PTR-projects/PTR_arecorder/docs/Arecorder_v.2.2_2016.07.30.pdf

# Arecorder

v. 2.2


## Arkadiusz Palinski ´

## Gdansk, 2016 rok ´

## Podziękowania

Specjalne podziękowania dla Andrzeja i Roberta Magiery, bez których nie udałoby mi się stworzyc Arecordera. ´

## Spis tresci ´

3.1.2. | Własciwe dane pomiarowe | ´ | 13
4.5. Stan 3 - silnik pierwszego stopnia się wyczerpał, oczekiwanie na minięcie
4.6. Stan 4 - oczekiwanie na odpalenie silnika drugiego stopnia i jednoczesne
4.9. Stan 7 - wyzwolono spadochron-pilot, oczekiwanie na wyst ąpienie

Spis tresci ´

4.14. Sygnalizowanie błędów i ostrzeze˙ n | ´ | 25

## 1. Wstęp

— pomiar cisnienia w zakresie 0 - 110 kPa (w zakresie 50 - 110 kPa z dokładno- ´

sci ą 100 Pa), ´
— pomiar przyspieszenia - trzy osie ± 24 g, jedna os (wzdłu ´ | z osi rakiety) ˙ | ± 80 g,
— pomiar temperatury wewn ątrz rakiety w zakresie -50 do +130 [◦C],

— zapis danych na karcie micro SD,

— próbkowanie danych z częstotliwosci ą 100 ´

Sa
s

,

— zaimplementowany filtr Kalmana do odszumienia pomiarów cisnienia, ´

— wykrywanie i sygnalizowanie podpiętych zapalników,

— wyzwalanie trzech zapalników - dwóch spadochronów i drugiego stopnia ra-

kiety,

— wyzwalanie spadochronu głównego po wykryciu awarii spadochronu-pilota,

— wykrywanie i zapis k ąta pochylenia rakiety na wyrzutni,

— pomiar napięcia zasilania Arecordera,

— programowalny czas opóźnienia pomiędzy koncem pracy pierwszego silnika a ´

odpaleniem silnika drugiego stopnia,

— wybór jednego z czterech zestawów parametrów konfiguracyjnych Arecordera,

— programowanie parametrów konfiguracyjnych Arecordera oraz imienia, nazwi-

ska i numeru telefonu własciciela oraz programowania prędko ´ | sci opadania ra- ´

kiety koniecznej do zadziałania awaryjnego wyzwalania spadochronu głów-

nego lub jego wył ączania za pomoc ą programu na komputerze PC,
— zapis podsumowania lotu w formie kilkunastu najwazniejszych parametrów ˙

lotu.

Arecorder jest urz ądzeniem przeznaczonym do rejestrowania danych podczas

lotu rakiety oraz wyzwalania zapalników w okreslonych chwilach. Urz ądzenie jest ´
przeznaczone do rakiet modelarskich srednich i du ´ | zych, równie ˙ | z dwustopniowych ˙

i naddźwiękowych. Zastosowane algorytmy pozwalaj ą na wykrycie sytuacji niety-
powych (np. lot pod duzym k ątem) i odpowiednio na nie zareagowa ˙ | c zmniejszaj ąc ´

ryzyko zniszczenia rakiety.
Nie jest konieczne przeczytanie całej instrukcji. Uzytkownik powinien jednak ˙

przeczytac rozdziały 1, 2, 4.2 i 4.3 oraz 7. ´

ROZDZIAŁ 1. WST ĘP

UWAGA - Jesli działanie Arecordera w dowolnym momencie odbiega od ´
zamierzonego, nalezy przesła ˙ | c wszelkie informacje o locie (w szczegól- ´

nosci pomiary Arecordera oraz filmy z lotu rakiety) na adres konstruktora ´

arekpalinski@gmail.com w celu weryfikacji działania Arecordera i ewen-

tualnej korekcji błędów. Konstruktor zastrzega sobie prawo do uaktualnie-

nia instrukcji bez uprzedniego powiadomienia

## 2. Opis wyprowadzen´

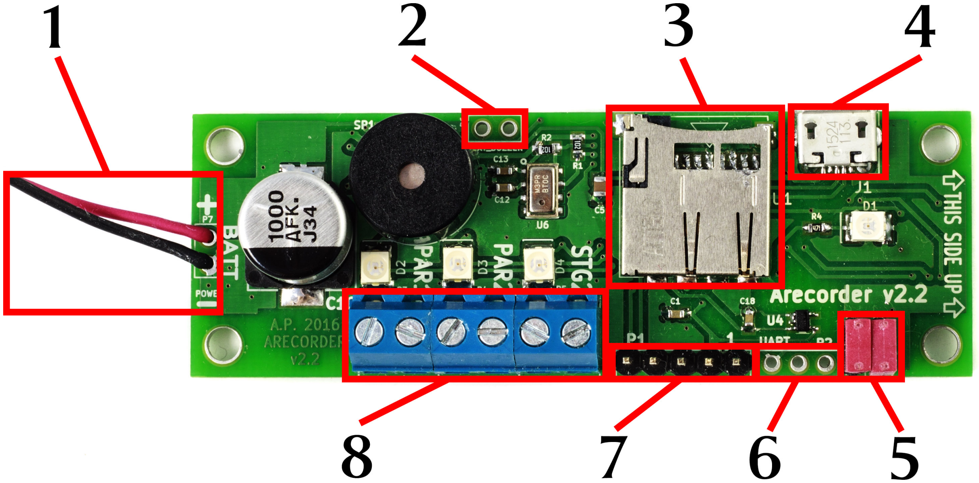
[picture p19: figure]

Rysunek 2.1: Opis wyprowadzen Arecordera. ´

1. zł ącze zasilania 2.1,
2. zł ącze dodatkowego brzęczyka 2.2,
3. zł ącze karty micro SD 2.3,
4. zł ącze USB programuj ące parametry Arecordera 2.4,
5. zł ącze wyboru zestawu ustawien 2.5, ´
6. zł ącze dodatkowe (obecnie nieaktywne),
7. zł ącze programuj ące mikrokontroler 2.6,
8. zł ącze do podł ączenia zapalników 2.7.

### 2.1. Zasilanie

Jako zasilanie moze by ˙ | c wykorzystane dowolne źródło napięcia w zakresie ´
4 - 10 V o niskiej impedancji (tj. mog ące oddac du ´ | zy pr ąd). Je ˙ | sli Arecorder jest ´

wykorzystywany wył ącznie jako rejestrator danych (nie ma wyzwalac zapalników ´
i nie s ą one do niego podł ączone), to zasilac go mo ´ | zna dowolnym źródłem napięcia ˙

w zakresie 3,8 - 10 V.

Zalecane zasilanie to jedno lub dwa ogniwa LiPo (w przypadku pojedynczego

ogniwa powinno ono byc w pełni naładowane). ´
Zobacz tez podrozdziały 5.1 i 5.2. ˙

ROZDZIAŁ 2. OPIS WYPROWADZEN´

### 2.2. Zł ącze dodatkowego brzęczyka

Do zł ącza dodatkowego brzęczyka mozna doł ączy ˙ | c dowolny brzęczyk, który ´
moze by ˙ | c zasilany stałym napięciem. Maksymalne napięcie zasilania doł ącza- ´
nego brzęczyka musi byc większe ni ´ | z napięcie zasilania Arecordera. Dodatkowy ˙
brzęczyk powinien byc stosowany jedynie w sytuacji, gdy gło ´ | sno ´ sć wbudowanego ´

brzęczyka jest niewystarczaj ąca.

### 2.3. Zł ącze karty micro SD

Tabela 2.1: Wkładanie i wyjmowanie karty SD

Nalezy wło ˙ zy˙ c kartę w otwór, lekko ´ docisn ąc i pu ´ sci ´ c. Karta cofnie się ´ odrobinę i zostanie zablokowana.

Aby wyj ąc kartę nale ´ zy j ą ponownie ˙ docisn ąc i pu ´ sci ´ c, karta cofnie się i bę- ´ dzie mozna j ą łatwo wyj ą ˙ c.´

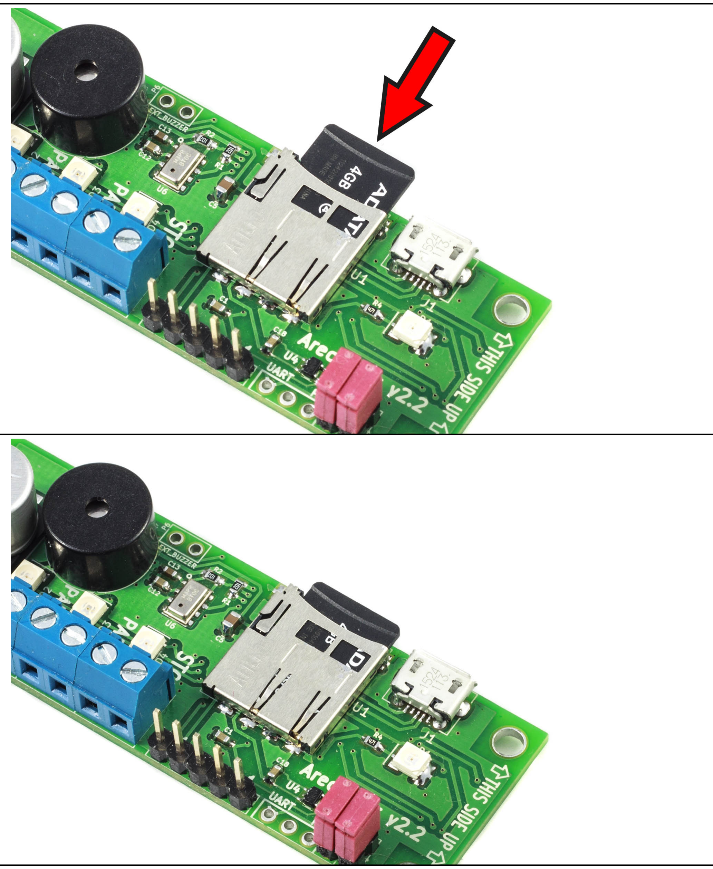
[picture p20: figure]

Do zł ącza karty SD nalezy wło ˙ zy˙ c kartę micro SD. Na tę kartę będ ą zapisywane ´

wszystkie pomierzone dane. Arecorder jest w stanie zapisac pliki o numerach ´ od 1 do 99 na jednej karcie (kazde wł ączenie Arecordera powoduje utworzenie ˙

dwóch plików o takich samych numerach - jednego pliku z danymi i jednego pliku
z podsumowaniem lotu), zaleca się jednakze formatowanie karty przed ka ˙ | zdym ˙

lotem.

Bardzo zalecana jest karta micro SDHC o mniejszej pojemnosci (mniejszej ´ niz 32 GB). ˙
Zaleca się formatowanie karty SD przed kazdym lotem, jednak ˙ | ze nie jest ˙

to konieczne.

ROZDZIAŁ 2. OPIS WYPROWADZEN´

### 2.4. Zł ącze USB programuj ące parametry Arecordera

Do zł ącza programuj ącego parametry Arecordera mozna podł ączy ˙ | c komputer ´

PC, na którym został zainstalowany program AreConfig. Umozliwi to zmiany na- ˙

staw konfiguracyjnych Arecordera, wpisanie imienia, nazwiska oraz numeru te-
lefonu własciciela, mo ´ | zliwo ˙ | sci wył ączenia awaryjnego wyzwalania spadochronu ´

głównego oraz przetestowanie wyzwalania zapalników.
Aby poł ączyc Arecorder z programem AreConfig nale ´ | zy wykona ˙ | c następuj ące ´
czynnosci w podanej kolejno ´ | sci: ´
1. Podł ączyc Arecorder poprzez kabel USB do komputera, ´
2. Wł ączyc program AreConfig, ´
3. Wybrac port, do którego doł ączony jest Arecorder. Zwykle wła ´ | sciwy port po- ´
winien byc wybrany od razu po wł ączeniu programu, je ´ | sli jednak tak nie jest ´
lub program wł ączono przed podł ączeniem Arecordera nalezy klikn ą ˙ | c przycisk ´
Przeskanuj i spróbowac poł ączy ´ | c się z wła ´ | sciwym portem. Zwykle powinien ´
byc jeden wykryty port. Je ´ | sli na li ´ | scie jest więcej ni ´ | z jeden port, mo ˙ | zna klik- ˙
n ąc prawym przyciskiem myszki na ´ | Mój Komputer i z rozwijanej listy wybrac´
Własciwo ´ | sci ´ , dalej Zaawansowane ustawienia systemu i w zakładkce Sprzęt
klikn ąc przycisk ´ | Menedzer urz ądze ń ˙ | . Z listy rozwin ąc pozycję ´ | Porty (COM i

LPT) - port, do którego jest podł ączony Arecorder będzie miał nazwę rozpo-

czynaj ąc ą się od USB Serial Port,

4. . Klikn ąc przycisk ´ | Poł ącz,
5. Arecorder automatycznie zostanie wykryty i poł ączy się z programem

AreConfig.

### 2.5. Zł ącze wyboru programu

Zł ącze wyboru zestawu ustawien słu ´ | zy do wyboru jednego z czterech pro- ˙
gramów - zestawów zaprogramowanych wczesniej ustawie ´ | n, za pomoc ą zworek. ´
Ustawienia, które s ą zmieniane w zalezno ˙ sci od wyboru programu to: ´
— wysokosć, na jakiej ma zosta ´ | c wyzwolony spadochron główny, ´

— wysokosć wyrzutni, ´

— opóźnienie wł ączenia silnika drugiego stopnia po zakonczeniu pracy silnika ´

pierwszego stopnia,

— prędkosci opadania rakiety, przy której nast ąpi awaryjne wyzwolenie spado- ´

chronu głównego (prędkosć “0” oznacza wył ączenie awaryjne wyzwolenie ´

spadochronu głównego).

Arecorder próbkuje zł ącze tylko raz, podczas wł ączenia. Późniejsze wyjęcie
lub włozenie zworek nie spowoduje zmiany ustawie ˙ | n.´

ROZDZIAŁ 2. OPIS WYPROWADZEN´

Tabela 2.2: Wybór numeru programu za pomoc ą zworek

numer programu

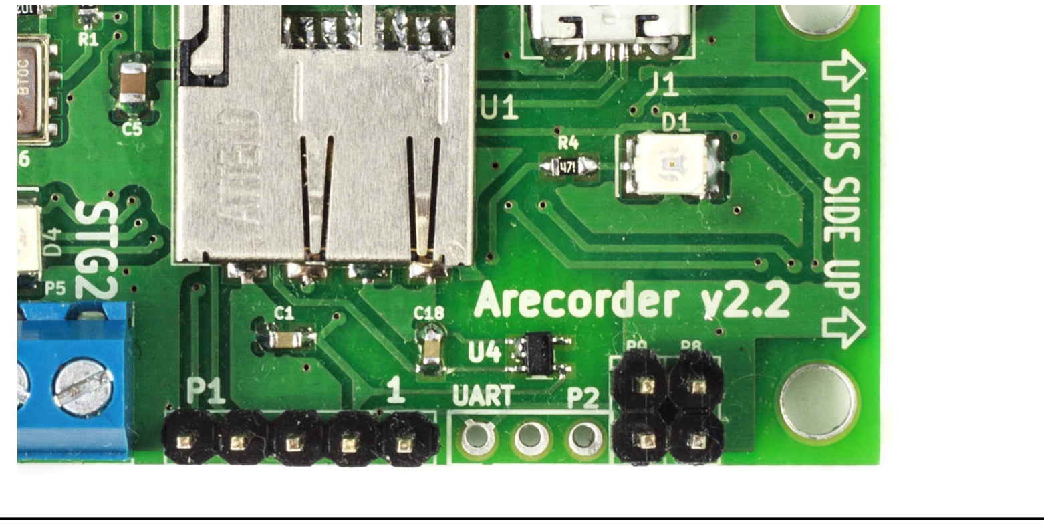
[picture p21: figure]

1

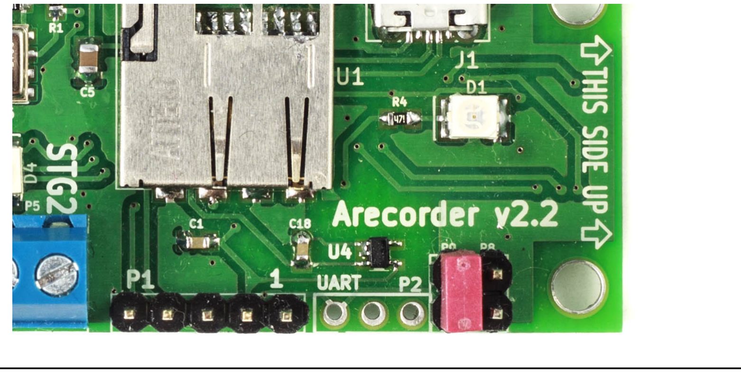
[picture p22: figure]

2

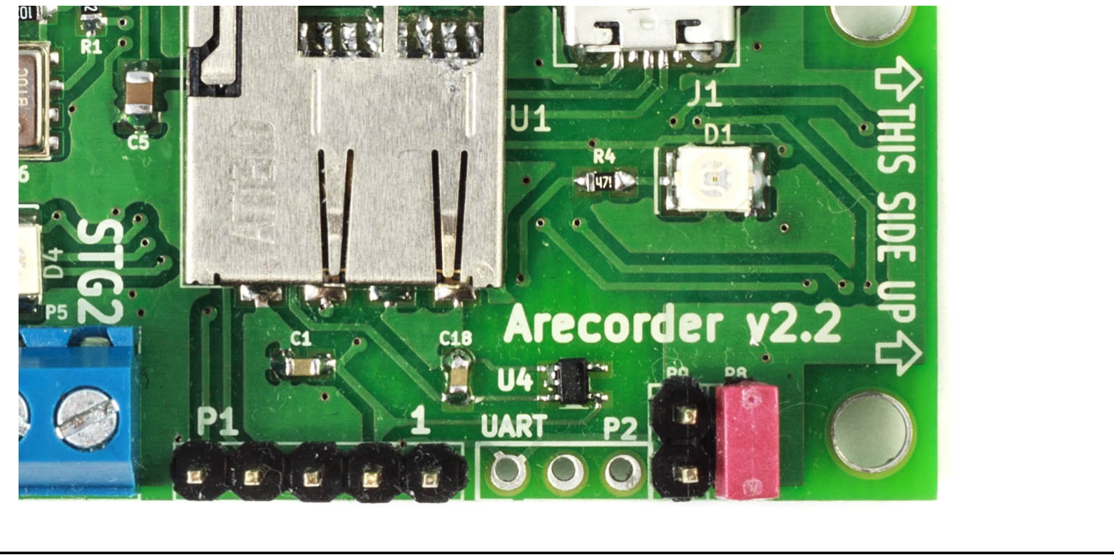
[picture p23: figure]

3

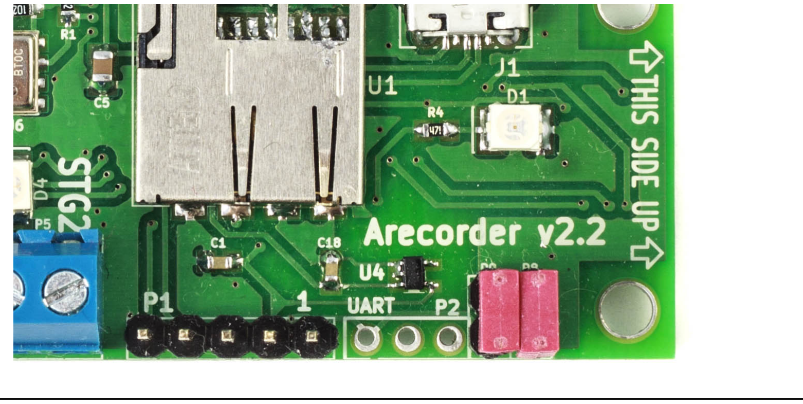
[picture p24: figure]

4

Tabela 2.3: Domyslne warto ´ | sci programów ´

numer

programu

spadochron

główny [m]

wysokosć´

wyrzutni [m]

opóźnienie

wyzwolenia zapalnika

drugiego stopnia [s]

awaryjne wyzwalanie

spadochronu przy

prędkosci [m/s] ´
1 | 200 | 1 | 0 | 50
2 | 150 | 1 | 0 | 50
3 | 100 | 1 | 0 | 50
4 | 50 | 1 | 0 | 50

ROZDZIAŁ 2. OPIS WYPROWADZEN´

### 2.6. Zł ącze programuj ące mikrokontroler

Zł ącze programuj ące mikrokontroler jest uzywane do aktualizacji oprogramo- ˙

wania Arecordera. Uzytkownik nie powinien u ˙ | zywa ˙ | c tego zł ącza. ´

### 2.7. Wyzwalanie zapalników

Zapalniki powinny byc doł ączone do odpowiedniego wyj ´ | scia (PAR1, PAR2 lub ´

STG2, które oznaczaj ą wyzwolenie zapalników odpowiednio spadochronu-pilota,

spadochronu głównego oraz drugiego członu rakiety).
Kazdy z zapalników jest doł ączony do zasilania dodatniego oraz do drenu od- ˙

powiadaj ącego mu tranzystora. W przypadku wyzwolenia zapalnika, tranzystor

jest wł ączany, co powoduje doł ączenie do zapalnika masy zasilania i przepływ
pr ądu o duzym natę ˙ | zeniu (zale ˙ | znym od źródła zasilania). ˙
Do kazdego z zapalników doł ączony jest tak ˙ | ze dodatkowy tranzystor, którego ˙

wł ączenie powoduje przepływ niewielkiego pr ądu przez zapalnik oraz diodę LED. Pr ąd ten jest zalezny od napięcia zasilania i wynosi ok. 2 - 8 mA. Jest to zbyt mały ˙

pr ąd, aby spowodował wyzwolenie zapalnika, a wystarczaj ący aby dioda LED za-
swieciła się informuj ąc, ´ | ze do danego wyj ˙ | scia doł ączony jest zapalnik. ´

## 3. Format danych zapisywanych na karcie SD

Dane s ą zapisane w formacie CSV, tj. poszczególne kolumny danych s ą od-

dzielone przecinkami a wiersze s ą oddzielone znakami nowej linii. Dane w takim
formacie mozna otworzy ˙ | c w dowolnym arkuszu kalkulacyjnym (przy importowa- ´
niu danych nalezy wybra ˙ | c język angielski - spowoduje to prawidłowe rozpoznanie ´

kropek jako znaków separuj ących częsci ułamkowe. ´

### 3.1. Format danych pliku z danymi pomiarowymi

Plik z danymi pomiarowymi dzieli się na trzy częsci - nagłówek, wła ´ | sciwe dane ´

pomiarowe oraz dane podsumowuj ące.

### 3.1.1. Nagłówek

W nagłówku zapisane s ą dane konfiguracyjne oraz kalibracyjne Arecordera
oraz imię, nazwisko i numer telefonu własciciela a tak ´ | ze informacje o wersji za- ˙

równo układu jak i oprogramowania Arecordera.

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

ROZDZIAŁ 3. FORMAT DANYCH ZAPISYWANYCH NA KARCIE SD

22 Sam ple s p e r sec o n d , 1 0 0
23
24 s e c o n d s , X_acc , Y_acc , Z_acc , HX_acc . . .
1. linia informuj ąca o wersji płytki Arecordera,
2. linia informuj ąca o wersji oprogramowania Arecordera (jest to czas, kiedy zo-

stał skompilowany kod),

3. numer seryjny,
4. nazwisko własciciela tego egzemplarza Arecordera, ´
5. numer telefonu własciciela, ´
6. numer zestawu ustawien wybranych w chwili wł ączenia Arecordera, ´
7. liczba działek, o które zmieniaj ą się wskazania akcelerometru ±24 g przy

zmianie przyspieszenia o 1 g,
8. liczba działek, o które zmieniaj ą się wskazania akcelerometru ±80 g przy

zmianie przyspieszenia o 1 g,
9. dana kalibracyjna - wartosć, jak ą wskazuje o ´ | s X akcelerometru ´ | ±24 g, gdy

mierzone przyspieszenie wynosi 0 g,
10. dana kalibracyjna - wartosć, jak ą wskazuje o ´ | s X akcelerometru ´ | ±80 g, gdy

mierzone przyspieszenie wynosi 0 g,
11. dana kalibracyjna - wartosć, jak ą wskazuje o ´ | s Y akcelerometru ´ | ±24 g, gdy

mierzone przyspieszenie wynosi 0 g,
12. dana kalibracyjna - wartosć, jak ą wskazuje o ´ | s Z akcelerometru ´ | ±24 g, gdy

mierzone przyspieszenie wynosi 0 g,
13. informacja o wykryciu czujnika ±80 g,
14. opóźnienie odpalenia silnika drugiego stopnia rakiety po zakonczonej pracy ´

silnika pierwszego stopnia (w sekundach),

15. wysokosć, na której powinien zosta ´ | c wyzwolony spadochron główny (w me- ´

trach),

16. wysokosć wyrzutni, z której rakieta startuje (w metrach), ´
17. prędkosci opadania rakiety, powy ´ | zej której zostanie wyzwolony spadochron ˙

głównego w przypadku awarii spadochronu pilota, wartosć zerowa oznacza ´

wył ączenie algorytmu,

18. dana kalibracyjna - wartosć, która jest odejmowana od wskaza ´ | n czujnika tem- ´
peratury (dane zapisywane s ą juz po korekcie, w stopniach Celsjusza), ˙
19. wartosć pierwszego współczynnika u ´ | zywanego przy obliczaniu wysoko ˙ | sci z ´

cisnienia, ´
20. wartosć drugiego współczynnika u ´ | zywanego przy obliczaniu wysoko ˙ | sci ci- ´

snienia, ´

21. cisnienie na poziomie morza (w Pa), warto ´ | sć stała, ´
22. liczba zapisywanych pomiarów w ci ągu sekundy,

ROZDZIAŁ 3. FORMAT DANYCH ZAPISYWANYCH NA KARCIE SD

24. opis poszczególnych kolumn własciwych danych. ´

### 3.1.2. Własciwe dane pomiarowe ´

Dane własciwe składaj ą się z następuj ących po sobie linii z danymi. W ka ´ | zdej ˙
linii poszczególne wartosci s ą oddzielone od siebie przecinkami, warto ´ | sci ułam- ´

kowe zapisywane s ą po kropce. Linia danych konczy się znakiem nowej linii (czyli ´

“enterem”).

Przykładowa linia danych wygl ąda następuj ąco:

48.81,145,34,-28,-10,102186,102182,14.9,2.4,0,0.3,1,0.0,0

gdzie:

48.81 | — czas w sekundach oraz w setnych częsciach sekund, ´
145,34,-28,-10 | — surowe dane przyspieszenia w osi X, osi Y, osi Z akcelero-
metru ±24 g oraz w osi X akcelerometru ±80 g (patrz sekcja

3.1.4),

102186,102182 | — cisnienie pomierzone bezpo ´ | srednio przez czujnik ci ´ | snienia ´
oraz cisnienie po u ´ | srednieniu przez filtr Kalmana, dane w [Pa], ´
14.9 | — temperatura pomierzona przez czujnik temperatury znajdu-
j ący się na Arecorderze, dane w [◦C]
2.4 | — prędkosć w osi rakiety obliczona przez Arecorder, dane ´ w [m s ]
0 | — wysokosć wyliczana z ci ´ | snienia, dane w [m], ´
0.3 | — wysokosć wyliczana z przyspieszenia, dane w [m], ´
1 | — numer stanu, w którym aktualnie znajduje się Arecorder
| (patrz tabela 4.1),
0.0 | — prędkosć wyliczana z ci ´ | snienia, ´
0 | — zmienna pomocnicza obliczana tylko w stanie 7 (patrz rów-
| niez 4.9), ˙

### 3.1.3. Dane podsumowuj ące

Jest to kopia danych z pliku podsumowuj ącego, patrz opis danych podsumo-

wuj ących w sekcji 3.2.

### 3.1.4. Konwersja danych

Aby pomierzone surowe dane z akcelerometrów były uzyteczne, nale ˙ | zy doko- ˙

nac konwersji na wybran ą jednostkę. ´

ROZDZIAŁ 3. FORMAT DANYCH ZAPISYWANYCH NA KARCIE SD

Aktualne wartosci X_1_g, Hx_1_g, X_0_g, Y_0_g, Z_0_g oraz Hx_0_g s ą ´

zawsze zapisywane w nagłówku pliku z danymi pomiarowymi.

a [g] = ameas − aof fset

again

, | (3.1)

gdzie:
a [g] - obliczone przyspieszenie w [g],

ameas - surowe dane z akcelerometrów,

aof fset - offset odpowiedni dla wybranego akcelerometru i osi odpowiednio X_0_g, Y_0_g, Z_0_g dla akcelerometru ±24 g lub Hx_0_g dla akcelerometru

±80 g,

again - współczynnik wzmocnienia, odpowiednio X_1_g dla akcelerometru ±24 g

lub Hx_1_g dla akcelerometru ±80 g.

a [

m
s

2

] = g · a [g], | (3.2)

gdzie:

a [

m
s

2 ] - obliczone przyspieszenie w [ m
s

2 ],
a [g] - obliczone przyspieszenie w [g], g - przyspieszenie grawitacyjne (9,81 m
s

2 ).

### 3.2. Format danych pliku z danymi podsumowuj ącymi

Dane podsumowuj ące s ą to lista kilkudziesięciu najwazniejszych parametrów ˙

charakteryzuj ących lot rakiety. Dane s ą zapisywane po wykryciu l ądowania ra-

kiety.

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

ROZDZIAŁ 3. FORMAT DANYCH ZAPISYWANYCH NA KARCIE SD

16 | R oc ket l a u n c h , 9 4 . 1 8 , [ s ]
17 | B u r n o ut o f f i r s t s t a g e e n gi n e , 9 5 . 5 2 , [ s ]
18 | I g n i t t i n g s e c o n d s t a g e e n gi n e f u s e , 9 5 . 6 3 , [ s ]
19 | F i r i n g s e c o n d s t a g e e n gi n e , 9 5 . 6 3 , [ s ]
20 | B u r n o ut o f s e c o n d s t a g e e n gi n e , 9 5 . 6 3 , [ s ]
21 | Apogee d e t e c t i o n , 1 0 3 . 7 2 , [ s ]
22 | Minimum v e l o c i t y a r o u n d apogee , 1 0 3 . 9 9 , [m/ s ]
23 | F i r i n g d r o g u e p a r a c h ut e , 1 0 4 . 7 0 , [ s ]
24 | F i r i n g main p a r a c h ut e , 1 2 5 . 7 6 , [ s ]
25 | R oc ket l a n di n g , 1 6 1 . 0 0 , [ s ]
26 | F i r s t e n gi n e b u r ni n g time , 1 . 3 4 , [ s ]
27 | Second e n gi n e b u r ni n g time , 0 , [ s ]
28 | Time t o apogee , 9 . 5 4 , [ s ]
29 | T o t a l f l i g h t time , 6 6 . 8 2 , [ s ]
1. k ąt, pod jakim pochylona jest rakieta na wyrzutni w chwili startu w stosunku do płaszczyzny podłoza, dane w [ ˙

◦
],
2. prędkosć w chwili opuszczenia wyrzutni, dane w [ ´

m
s

],

3. pomierzone cisnienie na poziomie ziemi w chwili startu, w [Pa], dane po filtrze ´

Kalmana,
4. pomierzone cisnienie w najwy ´ | zszym punkcie lotu, w [Pa], dane po filtrze Kal- ˙

mana,

5. maksymalna wartosć prędko ´ | sci w osi rakiety wyliczanej przez Arecorder z ´
przyspieszenia, dane w [m
s

],

6. maksymalna wysokosć osi ągnięta przez rakietę, w [m], dane wyliczone na pod- ´

stawie przyspieszenia,

7. maksymalna wysokosć osi ągnięta przez rakietę, w [m], dane wyliczone na pod- ´

stawie cisnienia, ´

8. prędkosć w chwili wykrycia ko ´ | nca pracy silnika pierwszego stopnia, dane ´
w [m
s

],

9. wysokosć w chwili wykrycia ko ´ | nca pracy silnika pierwszego stopnia, dane ´

w [m],

10. cisnienie w chwili wykrycia ko ´ | nca pracy silnika pierwszego stopnia, dane ´

w [Pa],

11. k ąt pochylenia rakiety do pionu w chwili wykrycia konca pracy silnika pierw- ´ szego stopnia, dane w [◦
],
12. prędkosć w chwili wykrycia ko ´ | nca pracy silnika drugiego stopnia, dane w [ ´

m
s

],

13. wysokosć w chwili wykrycia ko ´ | nca pracy silnika drugiego stopnia, dane ´

w [m],

14. cisnienie w chwili wykrycia ko ´ | nca pracy silnika drugiego stopnia, dane w [Pa], ´
15. k ąt pochylenia rakiety do pionu w chwili wykrycia konca pracy silnika dru- ´ giego stopnia, dane w [◦
],

ROZDZIAŁ 3. FORMAT DANYCH ZAPISYWANYCH NA KARCIE SD

16. czas, w którym został wykryty start rakiety, dane w [s],
17. czas, w którym został wykryty koniec pracy silnika pierwszego stopnia, dane

w [s],

18. czas, w którym został odpalony zapalnik rozpoczynaj ący pracę silnika dru-

giego stopnia, dane w [s],

19. czas, w którym został wykryty pocz ątek pracy silnika drugiego stopnia - wy-

zwolenie zapalnika nie jest jednoznaczne z rozpoczęciem pracy silnika dru-

giego stopnia, więc te dwa czasy s ą rozdzielone, dane w [s],

20. czas, w którym został wykryty koniec pracy silnika drugiego stopnia, dane

w [s],

21. czas, w którym zostało wykryte osi ągnięcie pułapu maksymalnego, dane w [s],
22. czas, w którym została wykryta minimalna prędkosć rakiety po sko ´ | nczeniu ´

pracy silników a przed wyzwoleniem spadochronu, dane w [s],

23. czas, w którym został odpalony zapalnik spadochronu-pilota, dane w [s],
24. czas, w którym został odpalony zapalnik spadochronu głównego, dane w [s],
25. czas, w którym zostało wykryte wyl ądowanie rakiety na ziemi (wykrycie na-

stępuje kilka sekund po faktycznym wyl ądowaniu), dane w [s],
26. czas pracy silnika pierwszego stopnia (róznica czasów pocz ątku i ko ˙ | nca pracy ´

silnika), dane w [s],
27. czas pracy silnika drugiego stopnia (róznica czasów pocz ątku i ko ˙ | nca pracy ´

silnika), dane w [s],

28. czas od chwili startu do osi ągnięcia przez rakietę pułapu, dane w [s],
29. całkowity czas lotu rakiety (czas od chwili wykrycia startu do chwili wykrycia l ądowania, z powodu opóźnienia w wykrycia l ądowania, ten czas moze by ˙ c o ´

kilka sekund za długi), dane w [s],

Dla danych od pozycji 16 do 21 oraz od 23 do 25 czas jest podawany od

chwili wł ączenia Arecordera.

## 4. Opis działania

Po wł ączeniu Arecorder jest w jednym ze zdefiniowanych stanów. Kazdy stan ˙

oznacza inn ą częsć lotu rakiety i inne decyzje podejmowane przez Arecorder. ´

Tabela 4.1: Stany Arecordera

numer stanu | opis
0 | oczekiwanie na inicjalizację
1 | oczekiwanie na start rakiety
2 | silnik pierwszego stopnia aktywny
3 | silnik pierwszego stopnia się wyczerpał, oczekiwanie na mi- nięcie opóźnienia odpalenia silnika drugiego stopnia
4 | oczekiwanie na odpalenie silnika drugiego stopnia i jednocze- sne oczekiwanie na osi ągnięcie pułapu
5 | silnik drugiego stopnia aktywny
6 | silnik drugiego stopnia się wyczerpał, oczekiwanie na osi ą- gnięcie pułapu
7 | wyzwolono spadochron-pilot, oczekiwanie na wyst ąpienie warunku wyzwolenia spadochronu głównego
8 | oczekiwanie na l ądowanie
9 | rakieta wyl ądowała
10 | zatrzymanie zapisywania danych
11 | pikanie brzęczyka

### 4.1. Obliczenia dokonywane przez Arecorder

Surowe dane pomierzone przez Arecorder to pomiary przyspieszenia w trzech osiach (±24 g w trzech osiach oraz ±80 g w osi rakiety), pomiary cisnienia oraz ´

pomiary temperatury (pomiar temperatury jako jedyny nie jest uzywany przez Are- ˙

corder do jakichkolwiek obliczen). Te dane s ą zapisywane w postaci surowej (bez- ´
posrednio odczytanej z czujników przez Arecorder, bez ´ | zadnej obróbki), jedynie ˙

temperatura jest konwertowana z pomierzonego napięcia na czujniku do wartosci ´ temperatury w [◦C] oraz dodawana jest do niej wartosć korekcji. ´

| Przed startem, Arecorder wylicza z przyspieszenia k ąt, pod jakim rakieta jest

pochylona na wyrzutni. Jest to k ąt pomiędzy osi ą rakiety a powierzchni ą prostopa-

ROZDZIAŁ 4. OPIS DZIAŁANIA


Rysunek 4.1: Osie, w których poszczególne akcelerometry mierz ą przyspieszenia.

dł ą do lokalnego pionu. K ąt ten jest uzywany do wyliczania wysoko ˙ | sci osi ągniętej ´
przez rakietę oraz prędkosci rakiety w czasie lotu; wa ´ | zne jest więc dokładne umiej- ˙
scowienie Arecordera we wnętrzu rakiety, aby os Arecordera i o ´ | s rakiety były jak ´
najbardziej do siebie zblizone. Zobacz tak ˙ | ze rysunek A.1. ˙

K ąt pochylenia rakiety jest cały czas aktualizowany, jesli więc po wł ączeniu ´

Arecordera a przed startem k ąt pochylenia rakiety ulegnie zmianie, to k ąt pochyłu

rakiety zostanie zaktualizowany a zmiana uwzględniona. Po wykryciu startu ra-
kiety k ąt jest blokowany do czasu, az rakieta opu ˙ | sci wyrzutnię. Następuje wtedy ´

obliczanie k ąta na podstawie przyspieszen działaj ących na rakietę (czyli ci ągu sil- ´
nika oraz grawitacji) i wczesniejszego k ąta. Zobacz tak ´ | ze wzór B.12. ˙
Arecorder moze zosta ˙ | c wł ączony, gdy rakieta jest w pozycji poziomej, zo- ´

stanie to prawidłowo wykryte.

Na podstawie przyspieszenia w osi rakiety oraz k ąta pochyłu rakiety podczas

lotu, Arecorder wylicza prędkosć rakiety w osi rakiety, prędko ´ | sć wznoszenia się ´
rakiety, wysokosć, na jak ą rakieta zdołała się wznie ´ | | sć oraz aktualizuje k ąt pochyłu ´

rakiety względem powierzchni ziemi. Prędkosć rakiety jest wyliczana z akcelero- ´ metru ±24 g, ale w przypadku, gdy pomierzone przez ten akcelerometr przyspie-

szenie będzie większe niz 20 g, to Arecorder będzie wyliczał prędko ˙ | sć korzystaj ąc ´
z danych z akcelerometru ±80 g.
Cisnienie jest na pocz ątku filtrowane filtrem Kalmana, aby je odszumi ´ | c. Na- ´
stępnie z cisnienia wyliczana jest warto ´ | sć wysoko ´ | sci pozycji startowej nad po- ´

ziomem morza, względem której będzie obliczana wysokosć, na któr ą wzleciała ´

rakieta.

ROZDZIAŁ 4. OPIS DZIAŁANIA

### 4.2. Stan 0 - oczekiwanie na inicjalizację

Po wł ączeniu zasilania, Arecorder wykrywa numer wybranego zestawu usta-

wien i piszczy brzęczykiem jego numer. Następnie odczytywane s ą ustawienia ´

z pamięci nieulotnej. Jesli wyst ąpi bł ąd w odczycie, Arecorder zasygnalizuje to ´
brzęczeniem brzęczyka. Moze to by ˙ | c jedynie ostrze ´ | zenie, Arecorder będzie kon- ˙
tynuował pracę, ale moze to te ˙ | z by ˙ | c bł ąd uniemo ´ | zliwiaj ący dalsze funkcjonowanie ˙
Arecordera. W dalszej kolejnosci inicjalizowany jest czujnik ci ´ | snienia - je ´ | sli ini- ´
cjalizacja się nie powiedzie, Arecorder zgłosi bł ąd - zobacz tez sekcję po ˙ | swięcon ą ´
błędom i ostrzezeniom 4.14. Następnie mierzy napięcie zasilania na baterii - je ˙ | sli ´

napięcie to jest zerowe, oznacza to, ze Arecorder jest zasilany ze zł ącza USB i ˙

przechodzi w tryb “Konfiguracji”. W przeciwnym wypadku Arecorder przechodzi

w tryb “Lotu”. Po przejsciu w okre ´ | slony tryb, Arecorder pozostaje w nim do ko ´ | nca ´
zasilania, umozliwia to późniejsze podł ączenie zasilania baterii w trybie “Konfi- ˙

guracji” w celu przetestowania zapalników. Taki sposób działania uniemozliwia ˙

przejscie w tryb “Konfiguracji” podczas lotu w rakiecie. ´

Przed decyzj ą o wyborze trybu działania, Arecorder inicjalizuje czujniki, od-

czytuje zaprogramowane ustawienia, zapisuje wartosć ci ´ snienia odniesienia (z któ- ´

rej jest wyliczana wysokosć bezwzględna wyrzutni) oraz rozpoczyna testowanie ´

obecnosci zapalników (gdy testowanie obecno ´ | sci zapalników jest wł ączone, czer- ´
wone diody LED zaczynaj ą się swieci ´ | c przy zapalnikach, które zostały wykryte). ´

### 4.2.1. Tryb konfiguracji

Aby przejsć w tryb konfiguracji, Arecorder musi zosta ´ | c doł ączony do kompu- ´

tera poprzez kabel USB. Na komputerze musi byc wł ączony program Areconfig ´

i wybrany odpowiedni port, poprzez który będzie następowała konfiguracja. Zo-

bacz instrukcję do programu Areconfig lub zajrzyj do sekcji 2.4 w celu uzyskania

dokładniejszego opisu.
W trybie konfiguracji mozna dokona ˙ | c edycji ustawie ´ | n Arecordera: ´
— wysokosć, na której ma zosta ´ | c wyzwolony spadochron główny, ´

— wysokosć wyrzutni, ´

— czas pomiędzy koncem pracy silnika pierwszego stopnia a odpaleniem silnika ´

drugiego stopnia,

— imię, nazwisko oraz numer telefonu własciciela. ´

Pomijaj ąc ostatni ą pozycję, wszystkie ustawienia programuje się osobno dla
czterech róznych zestawów ustawie ˙ | n wybieranych zworkami. ´
W | trybie | konfiguracji | Arecorder | pozostaje | cały | czas | w | stanie

AWAITING_FOR_ARECORDER_READY.

Szczegółowy opis konfiguracji jest zamieszczony w instrukcji obsługi pro-

gramu Areconfig - http://www.palinski.org/Areconfig.

ROZDZIAŁ 4. OPIS DZIAŁANIA

### 4.2.2. Tryb Lotu

W trybie lotu mierzone jest napięcie zasilania - jesli wynosi ono poni ´ | zej 3,8 V, ˙
Arecorder zgłasza ostrzezenie, zobacz tak ˙ | ze 4.14. Następnie inicjalizowana jest ˙

karta SD i następuje utworzenie dwóch plików, do których będ ą zapisywane dane

- pliku o nazwie “MEASxx.CSV” oraz “SUMMxx.CSV”, gdzie xx to numer nada-

wany kolejnym zapisywanym plikom z danymi na karcie SD; numery odpowiadaj ących sobie plików MEAS i SUMM s ą zawsze takie same. Przy kazdym wł ą- ˙

czeniu Arecorder odczytuje czy na karcie s ą zapisane jakies poprzednie pliki z ´

danymi i tworzy nowe pliki z numerem większym o jeden od poprzednio zapisa-
nego; Arecorder moze w ten sposób zapisa ˙ | c do 99 plików, zarówno MEAS jak i ´

SUMM, na jednej karcie SD. Zaleca się jednak kazdorazowe formatowanie karty ˙

przed kazdym lotem. Gdy liczba pomiarów na karcie przekroczy 90, Arecorder ˙

zgłosi ostrzezenie, natomiast gdy na karcie znajduje się ju ˙ | z 99 pomiarów, Arecoder ˙
zgłosi bł ąd, ze nie mo ˙ | ze ju ˙ | z zapisa ˙ | c więcej pomiarów, zobacz tak ´ | ze 4.14. ˙

Po utworzeniu plików na karcie, następuj ą trzy piski brzęczyka - kazdy z tych ˙

pisków oznacza obecnosć lub brak odpowiedniego zapalnika. Krótkim piskiem sy- ´

gnalizowana jest obecnosć zapalnika, natomiast długim jego brak. Pierwszy pisk ´

oznacza zapalnik spadochronu-pilota, drugi zapalnik spadochronu głównego, na-

tomiast trzeci zapalnik drugiego stopnia rakiety.

Następnie następuje zapis do pliku MEAS danych konfiguracyjnych oraz je-
den długi pisk informuj ący uzytkownika, ˙ | ze od tej chwili Arecorder dokonuje po- ˙

miarów i wykrywa start; od tej chwili równiez dioda zielona dioda LED zaczyna ˙

migac. Po dziesięciu sekundach wył ączane jest testowanie zapalników (czerwone ´

diody przestaj ą migac). Arecorder przechodzi do stanu 1. ´

UWAGA - Po wł ączeniu Arecordera i zasygnalizowaniu rozpoczęcia wy-

krywania startu, zalecane jest odczekanie około dwóch minut na ustabili-

zowanie wskazan czujnika ci ´ | snienia. ´
W przypadku wczesniejszego startu ró ´ | znica błędnych wskaza ˙ | n wysoko ´ | sci ´
obliczona z czujnika cisnienia mo ´ | ze wynie ˙ | sć nawet kilka metrów. ´
W celu skompensowania tego błędu nalezy do oblicze ˙ | n wysoko ´ | sci jako ci- ´
snienia odniesienia (wysoko ´ | sci wyrzutni) u ´ | zy˙ c warto ´ | sci ´ sredniej z dwóch ´
pomiarów cisnienia - jednego z danych lotu tu ´ | z przed startem rakiety oraz ˙

drugiego z miejsca startu rakiety czujnikiem po ustabilizowaniu wskazan,´

w niedługim czasie po wyl ądowaniu.

Arecorder za pomoc ą pisków brzęczyka informuje o wybranym zestawie usta-

wien, o doł ączonych zapalnikach oraz o rozpoczęciu wykrywania startu rakiety. ´

Najpierw liczba pisków informuje o wybranym zestawie parametrów. Po krótkiej

ROZDZIAŁ 4. OPIS DZIAŁANIA

przerwie następuj ą kolejne trzy piski informuj ące o wykrytych b ądź nie zapal-

nikach (krótki pisk oznacza wykryty zapalnik, długi brak wykrytego zapalnika).

Pierwszy pisk to zapalnik spadochrona-pilota, drugi - zapalnik głównego spado-

chronu a trzeci zapalnik silnika drugiego stopnia rakiety. Na koncu, po kolejnej ´ przerwie, występuje jeden długi pisk informuj ący, ze Arecorder rozpocz ął pomiary. ˙

Przykładowo, następuj ąca sekwencja pisków (krótka linia to krótki pisk, a
długa linia to długi pisk, dłuzsza przerwa oznacza zauwa ˙ | zalnie dłu ˙ | zsz ą przerwę ˙

między kolejnymi sekwencjami pisków):
- - | - - — | — oznacza, ze aktywny jest program drugi (wybrany jest drugi zestaw ustawie ˙ | n), ´

wykryto zapalniki podł ączone do obu spadochronów, ale nie do silnika drugiego
stopnia, oraz, ze Arecorder rozpocz ął pomiary i rakieta mo ˙ | ze startowa ˙ | c.´

### 4.3. Stan 1 - oczekiwanie na start rakiety

W tym stanie Arecorder jest zainicjalizowany i próbkuje dane z czujników w

celu wykrycia startu rakiety.

Start rakiety jest wykrywany, gdy rakieta wzniesie się na wysokosć większ ą ´
niz wysoko ˙ | sć wyrzutni (wysoko ´ | sć wyrzutni jest programowana wcze ´ | sniej). Na ´

podstawie pomiarów przyspieszenia jest wyliczana prędkosć rakiety oraz wyso- ´

kosć, na jak ą rakieta się wzniosła. Dodatkowo, je ´ | sli pomierzone przyspieszenie ´
jest większe niz 1,2 g (tzn. rakieta wznosi się do góry z przyspieszeniem więk- ˙

szym niz 0,2 g), to zostanie wł ączony brzęczyk informuj ący o potencjalnym starcie ˙

(az do potwierdzenia startu poprzez osi ągnięcie wysoko ˙ | sci wy ´ | zszej ni ˙ | z wysoko ˙ | sć´

wyrzutni).

Gdy po wł ączeniu Arecordera rakieta jest poruszana na wyrzutni, moze się ˙

zdarzyc,´ ze chwilowo zostanie wykryte przyspieszenie większe ni ˙ | | | z 1,2 g. ˙

Arecorder wł ączy na chwilę brzęczyk sygnalizuj ąc potencjalne wykrycie

startu, ale zaraz go wył ączy, gdy tylko chwilowe przyspieszenie znowu

spadnie. Jest to całkowicie normalne zachowanie a start nie zostanie wy-
kryty dopóki rakieta nie osi ągnie wysokosci wy ´ | zszej ni ˙ | z wysoko ˙ | sć wy- ´

rzutni.

W tym stanie, jesli nie jest wykrywany start, następuje aktualizacja ci ´ | snienia ´

odniesienia oraz k ąta pochylenia rakiety.

Jesli zostanie wykryty start rakiety, Arecorder zacznie zapisywa ´ | c dane na ´

kartę SD wraz z kilkunastoma próbkami danych przed startem. W chwili wykrycia

ROZDZIAŁ 4. OPIS DZIAŁANIA

startu zostanie równiez zapisany czas startu rakiety (do późniejszego pliku podsu- ˙

mowuj ącego).

Po wykryciu startu, Arecorder przechodzi do stanu 2.

### 4.4. Stan 2 - silnik pierwszego stopnia aktywny

W stanie drugim rakieta leci i silnik pierwszego stopnia jest aktywny, tj. siła

ci ągu silnika jest większa od oporu aerodynamicznego rakiety (czyli przyspiesze-

nie w osi rakiety jest większe od zera a rakieta zwiększa swoj ą prędkosć). Je ´ sli ´ przyspieszenie rakiety będzie mniejsze niz zero, zostanie wykryty koniec pracy ˙

silnika. Przyspieszenie jest filtrowane, przez co pojedynczy pomiar nie spowoduje

fałszywego zadziałania algorytmu.

Po wykryciu konca pracy silnika, zapisywany jest czas ko ´ | nca pracy silnika ´

pierwszego stopnia i Arecorder przechodzi do stanu 3.

### 4.5. Stan 3 - silnik pierwszego stopnia się wyczerpał, oczekiwanie na

minięcie opóźnienia odpalenia silnika drugiego stopnia

Stan trzeci to oczekiwanie, az minie zaprogramowany czas opóźnienia; po tym ˙

czasie zostaje wyzwolony zapalnik drugiego stopnia rakiety.
Równiez i tym razem jest zapisywany czas - czas wyzwolenia zapalnika dru- ˙

giego stopnia rakiety.

Po minięciu opóźnienia Arecorder przechodzi do stanu 4.

### 4.6. Stan 4 - oczekiwanie na odpalenie silnika drugiego stopnia i

jednoczesne oczekiwanie na osi ągnięcie pułapu

Stan czwarty to jednoczesnie oczekiwanie na odpalenie silnika drugiego stop- ´

nia i oczekiwanie na osi ągnięcie pułapu.
Jesli ci ąg silnika będzie większy ni ´ | z opór aerodynamiczny rakiety, to znaczy, ˙

ze silnik drugiego stopnia jest aktywny. W czasie gdy silnik drugiego stopnia jest ˙

aktywny, blokowane jest wyzwolenie spadochronu-pilota. Jesli silnik drugiego ´

stopnia będzie aktywny przez co najmniej pół sekundy, to Arecorder przechodzi

do stanu 5.

W przypadku braku silnika drugiego stopnia lub nieodpalenia silnika drugiego

stopnia, przez cały czas badany jest warunek wyzwolenia spadochronu-pilota. Ten warunek został opisany w stanie 6 - sekcja 4.8, gdyz s ą one identyczne. W przy- ˙

padku wyzwolenia spadochronu-pilota, Arecorder przechodzi do stanu 7.

W tym stanie jest zapisywany czas pocz ątku pracy silnika drugiego stopnia

lub, w przypadku braku silnika drugiego stopnia (lub nieodpalenia silnika dru-

ROZDZIAŁ 4. OPIS DZIAŁANIA

giego stopnia) zapisywany jest czas osi ągnięcia maksymalnego pułapu oraz czas

minimalnej prędkosci rakiety. ´

### 4.7. Stan 5 - silnik drugiego stopnia aktywny

W stanie pi ątym Arecorder wykrył wł ączenie silnika drugiego stopnia i oczekuje na koniec jego pracy. W tym stanie nie jest mozliwe wyzwolenie spadochronu. ˙

Podobnie jak w stanie drugim, jesli siła ci ągu silnika jest większa od oporu ´

aerodynamicznego rakiety, to Arecorder pozostaje w stanie 5, w przeciwnym przy-

padku Arecorder przechodzi do stanu 6.

W tym stanie zapisywany jest czas konca pracy silnika drugiego stopnia. ´

### 4.8. Stan 6 - oczekiwanie na osi ągnięcie pułapu

Stan szósty to wykrywanie osi ągnięcia pułapu rakiety. Arecorder bada czy
cisnienie zaczyna się zwiększa ´ | c (co oznacza obni ´ | zanie wysoko ˙ | sci, na której znaj- ´
duje się rakieta). Jesli ci ´ | snienie po filtrze Kalmana przez jedn ą sekundę będzie ´
większe niz najmniejsze zarejestrowane ci ˙ | snienie, to Arecorder podejmuje decyzję ´
co do dalszego postępowania na podstawie wysokosci wyliczonej z ci ´ | snienia. Je ´ | sli ´
wysokosć jest mniejsza ni ´ | z 200 metrów, to spadochron-pilot jest wyzwalany na- ˙
tychmiast. Jesli wysoko ´ | sć rakiety jest większa ni ´ | z 200 metrów, to Arecorder czeka ˙
z wyzwoleniem spadochronu-pilota, az wyliczona prędko ˙ | sć w osi rakiety spadnie ´

do minimum.

W przypadku, gdy k ąt pochylenia rakiety jest niewielki, prędkosć osiowa ra- ´
kiety po przekroczeniu pułapu moze osi ągn ą ˙ | c warto ´ | sć na tyle du ´ | z ą, ˙ ze wyzwolenie ˙

spadochronu-pilota spowodowałoby jego zerwanie. Po osi ągnięciu pułapu, tarcie
powietrza moze by ˙ | c na tyle du ´ | ze, ˙ | ze prędko ˙ | sć w osi rakiety zmniejsza się mimo ´
opadania rakiety (tuz po przekroczeniu pułapu o ˙ | s rakiety jest niemal równoległa ´

do płaszczyzny ziemi, przez co składowa grawitacji w osi rakiety jest mniejsza niz opór aerodynamiczny). Opóźnienie wyzwolenia spadochronu-pilota do czasu, ˙

az prędko ˙ | sć w osi rakiety osi ągnie warto ´ | sć minimaln ą ma na celu zmniejszenie ´

ryzyka zerwania spadochronu-pilota.

W tym stanie zapisywany jest czas osi ągnięcia pułapu, czas osi ągnięcia mi-
nimalnej prędkosci oraz minimalne pomierzone ci ´ | snienie, które jest u ´ | zywane do ˙

obliczenia maksymalnej wysokosci. ´

Po wyzwoleniu spadochronu-pilota, Arecorder przechodzi do stanu 7.

ROZDZIAŁ 4. OPIS DZIAŁANIA

### 4.9. Stan 7 - wyzwolono spadochron-pilot, oczekiwanie na wyst ąpienie

warunku wyzwolenia spadochronu głównego

W stanie siódmym Arecorder bada zachowanie się rakiety po wyzwoleniu

spadochronu-pilota. Jesli rakieta opada na spadochronie, to spadochron główny ´
jest wyzwalany, gdy rakieta opadnie ponizej zaprogramowanej wcze ˙ | sniej wysoko- ´
sci wyzwolenia spadochronu głównego (domy ´ | slnie 200 metrów). ´

Arecorder wyzwoli spadochron główny na zaprogramowanej wczesniej wyso- ´

kosci w odniesieniu do punktu startowego. Je ´ | sli rakieta będzie opada ´ | c w miejscu, ´
które jest połozone wy ˙ | zej nad poziomem morza ni ˙ | z miejsce startu, faktyczna wy- ˙
sokosć względna, na której zostanie wyzwolony spadochron mo ´ | ze by ˙ | c ni ´ | zsza ni ˙ | z˙
zaprogramowana. Analogicznie, jesli rakieta opada nad miejscem poło ´ | zonym ni ˙ | zej ˙
nad poziomem morza niz miejsce startu, faktyczna wysoko ˙ | sć względna, na której ´
zostanie wyzwolony spadochron główny moze by ˙ | c wy ´ | zsza ni ˙ | z zaprogramowana. ˙
UWAGA - uzytkownik powinien wzi ą ˙ | c pod uwagę ukształtowanie terenu ´

w okolicy miejsca startowego podczas programowania wysokosci, na któ- ´

rej ma zostac wyzwolony spadochron główny. ´

Po wyzwoleniu spadochronu-pilota działa równoczesnie algorytm, który ma ´

za zadanie wykrycie czy spadochron-pilot został wyzwolony prawidłowo. Jesli ´
Arecorder wykryje, ze rakieta opada zbyt szybko, powy ˙ | zej okre ˙ | slonej prędko ´ | sci, ´

zostaje natychmiast wyzwolony spadochron główny. Graniczna prędkosć opada- ´
nia rakiety jest programowalna przez uzytkownika (wpisanie warto ˙ | sci 0 powoduje ´

wstrzymanie działania algorytmu, spadochron główny zostanie wtedy wyzwolony

tylko na zaprogramowanej wysokosci). ´

UWAGA - Jako wartosć progow ą prędko ´ | sci opadania rakiety zaleca się ´
ustawic warto ´ | sć dwa-trzy razy większ ą ni ´ | z prognozowan ą prędko ˙ | sć opada- ´
nia rakiety na spadochronie-pilocie. Domyslnie zaprogramowana warto ´ | sć´

to 50 [m/s].

W tym stanie Arecorder zapisuje czas wyzwolenia spadochronu głównego.

Po wyzwoleniu spadochronu głównego, Arecorder przechodzi do stanu 8.

ROZDZIAŁ 4. OPIS DZIAŁANIA

### 4.10. Stan 8 - oczekiwanie na l ądowanie

W tym stanie następuje badanie zmian cisnienia w celu okre ´ | slenia czy rakieta ´
wyl ądowała na ziemi. Poniewaz algorytm bada dane z filtru Kalmana, l ądowanie ˙
moze zosta ˙ | c wykryte nawet kilka sekund po faktycznym wyl ądowaniu rakiety. ´

W tym stanie Arecorder zapisuje czas wykrytego l ądowania rakiety.

Po wykryciu l ądowania, Arecorder przechodzi do stanu 9.

### 4.11. Stan 9 - rakieta wyl ądowała

Po wykryciu wyl ądowania rakiety, dla bezpieczenstwa Arecorder zapisuje jesz- ´

cze dziesięc sekund danych, po czym przechodzi do stanu 10. W stanie dziewi ątym ´ następuje równiez wł ączenie pikania brzęczyka. ˙

### 4.12. Stan 10 - zatrzymanie zapisywania danych

W stanie dziesi ątym następuje zatrzymanie zapisywania danych na kartę SD

oraz zapisanie danych podsumowuj ących zarówno do pliku z danymi podsumo-

wuj ącymi jak i do pliku z danymi pomiarowymi. Gdy wszystkie dane zostan ą

zapisane, Arecorder przechodzi do stanu 11.

### 4.13. Stan 11 - pikanie brzęczyka

W tym stanie co sekundę pika brzęczyk. Arecorder pozostaje w tym stanie

dopóki nie zostanie wył ączony.

### 4.14. Sygnalizowanie błędów i ostrzeze˙ n´

Istnieje kilka sytuacji, w których Arecorder nie moze kontynuowa ˙ | c działania ´
(błędy) albo ostrzega, ze Arecorder zbli ˙ | za się do stanu, gdy ju ˙ | z nie będzie mógł ˙
kontynuowac działania (ostrze ´ | zenia). Sygnalizowane jest to w następuj ący sposób: ˙

– przez sekundę piszczy brzęczyk oraz zapalona jest dioda, następnie przez pół

sekundy jest cisza a dioda jest zgaszona,

– zarówno brzęczyk piszczy a dioda jest zapalana tyle razy ile wynosi numer

błędu,

– przez sekundę piszczy brzęczyk oraz zapalona jest dioda,
– w przypadku ostrzezenia Arecorder kontynuuje działanie, ˙

– w przypadku błędu zapalana jest dioda a Arecorder wstrzymuje dalsze działa-

nie.

ROZDZIAŁ 4. OPIS DZIAŁANIA

Kody błędów s ą następuj ące:

Tabela 4.2: Kody błędów

kod błędu | typ błędu | opis
1 | ostrzezenie ˙ | niski poziom baterii - napięcie zasilania jest ponizej ˙

3.8 V
2 | ostrzezenie ˙ | na karcie SD znajduje się ponad 90 pomiarów
3 | bł ąd | na karcie SD znajduje się 99 pomiarów, nie mozna ˙

zapisac więcej ´
4 | ostrzezenie ˙ | wewnętrzna pamięc nieulotna została zapisana zbyt ´

wiele razy (więcej niz kilkadziesi ąt tysięcy razy). ˙

Ostrzezenie zgłaszane jest znacznie wcze ˙ | sniej ni ´ | z˙

mog ą wyst ąpic błędy w odczycie i zapisie do pa- ´
mięci nieulotnej, ale nalezy rozwa ˙ | zy˙ c zaprzestanie ´

uzywania tego egzemplarza Arecordera ˙

5 | bł ąd | bł ąd zapisu danych na wewnętrzn ą, nieulotn ą pa-
mięc. Je ´ | sli problem będzie się powtarzał, nale ´ | zy˙
rozwazy˙ c zaprzestanie u ´ | zywania tego egzemplarza ˙

Arecordera

6 | bł ąd | nie udało się zainicjalizowac działania czujnika ci- ´

snienia ´
7 | ostrzezenie ˙ | bł ąd podczas wysyłania do Arecordera polecenia za-

pisu danych do pamięci nieulotnej. Prawdopodobnie
uzytkownik u ˙ | zywa niewła ˙ | sciwej wersji programu ´

AreConfig

## 5. Parametry techniczne

### 5.1. Absolutnie maksymalne parametry

UWAGA Obci ązenia większe ni ˙ | | z opisane jako ˙ | Absolutnie maksymalne pa-

rametry mog ą spowodowac trwałe uszkodzenie Arecordera. To s ą tylko ´ maksymalne obci ązenia - prawidłowa praca Arecordera pod tymi obci ą- ˙

zeniami lub większymi ni ˙ | z opisanymi jako ˙ | Parametry elektryczne nie jest

gwarantowana. Długotrwałe wystawienie Arecordera na działanie maksy-
malnych obci ąze˙ n mo ´ | ze wpłyn ą ˙ | c na niezawodno ´ | sć urz ądzenia. ´

Tabela 5.1: Absolutnie maksymalne parametry

Parametr | Min | Maks | Jednostka | Uwagi
Napięcie zasilania | -0,7 | 10,5 | V
Przyspieszenie | - | 1000 | g | 1) , 2)
Cisnienie ´ | 0 | 110 | kPa
Temperatura podczas pracy | -50 | 85 | [ ◦C]
Temperatura podczas przechowywania | -50 | 125 | [ ◦C]
1) nie przetestowane w praktyce,
2) w dowolnej osi.

ROZDZIAŁ 5. PARAMETRY TECHNICZNE

### 5.2. Parametry elektryczne

Tabela 5.2: Parametry elektryczne

Parametr | Min | Typ | Maks | Jednostka | Uwagi
Napięcie zasilania | 4 | 4,2 | 10,5 | V | 1)
| 3,8 | 4,2 | 10,5 | V | 2)
Pobór pr ądu | 28,8 | - | 31,7 | mA | 3) 4)
| 30 | - | 36 | mA | 3) 5)
| - | 35 | - | mA | 6)
Zakres mierzonego przyspieszenia | 0 | - | 24 | g | 7)
| 0 | - | 80 | g | 8)
Rozdzielczosć´ mierzonego przyspieszenia | - | 0,042 | - | g | 7)
| - | 0,012 | - | g | 8)
Zakres mierzonego cisnienia ´ | 0 | - | 110 | kPa
Rozdzielczosć mierzonego ´ cisnienia ´ | - | 1,5 | - | Pa

Zakres mierzonej

temperatury

-55 | - | 130 | [
◦C] | 9)

Rozdzielczosć mierzonej ´

temperatury

- | 0,25 | - | [ ◦C]
1) w przypadku, gdy Arecorder wyzwala zapalniki,
2) w przypadku, gdy Arecorder jedynie mierzy parametry lotu,
3) pomijaj ąc chwilę, gdy zapalnik jest wyzwalany,
4) pobór pr ądu gdy dane nie s ą zapisywane na kartę SD,
5) pobór pr ądu gdy dane s ą zapisywane na kartę SD,
6) sredni pobór pr ądu w stanie 11 - pikanie brzęczyka, ´
7) akcelerometr LIS331HH, wszystkie trzy osie,
8) akcelerometr MMA6519, jedna os,´
9) zakres pomiarowy czujnika temperatury przekracza zakres pracy całego

Arecordera,

ROZDZIAŁ 5. PARAMETRY TECHNICZNE

### 5.3. Parametry fizyczne i mechaniczne

Tabela 5.3: Parametry fizyczne i mechaniczne

Parametr | | Jednostka | Uwagi
Szerokosć´ | 25 | mm | 1)
Długosć´ | 74 | mm
Wysokosć´ | 14 | mm | 2)
Masa | 16,4 | g
1) w przypadku podł ączenia zapalników, nalezy zostawi ˙ | c dodatkow ą przestrze ´ | n z ´

boku Arecordera,

2) maksymalna wysokosć elementu nad płytk ą wynosi 10,5 mm, pod płytk ą 2 mm, ´

płytka ma grubosć 1,5 mm, ´

## 6. Wymiarowanie

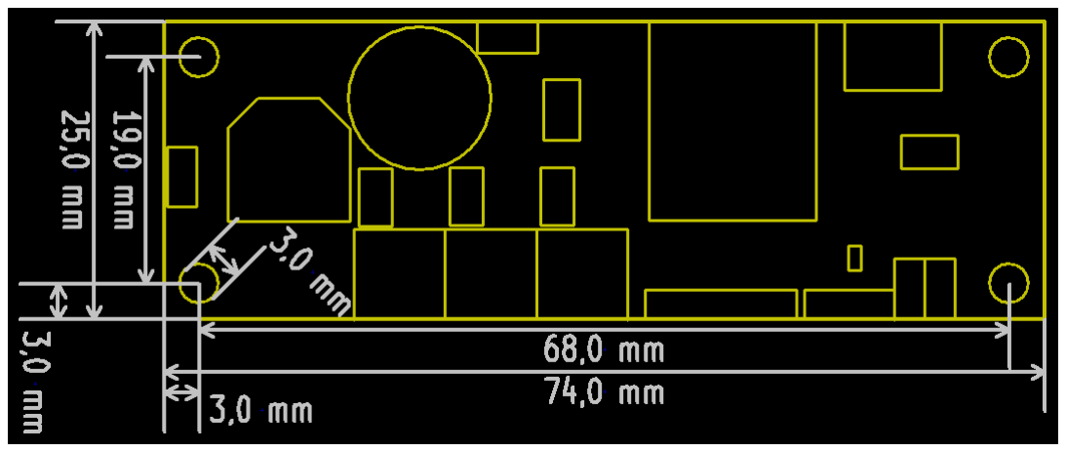
[picture p25: figure]

Rysunek 6.1: Wymiarowanie Arecordera z zaznaczonymi konturami wazniejszych ˙

elementów strony górnej.


Rysunek 6.2: Połozenie wa ˙ | zniejszych elementów na stronie górnej Arecordera. ˙

C16 - kondensator,

D1 - pomaranczowa dioda LED, ´

D2, D3, D4 - czerwone diody LED,

P1 - zł ącze programuj ące mikrokontroler,

P2 - dodatkowe zł ącze programuj ące parametry Arecordera,

P3, P4, P5 - zł ącza do podł ączenia zapalników,

P6 - zł ącze dodatkowego brzęczyka,

P7 - zł ącze zasilania,

P8, P9 - zł ącza wyboru zestawu ustawien,´

P10 - gniazdo do karty micro SD,

P11 - zł ącze programuj ące parametry Arecordera,

ROZDZIAŁ 6. WYMIAROWANIE

SP1 - brzęczyk,

U4 - czujnik temperatury,

U6 - czujnik cisnienia. ´

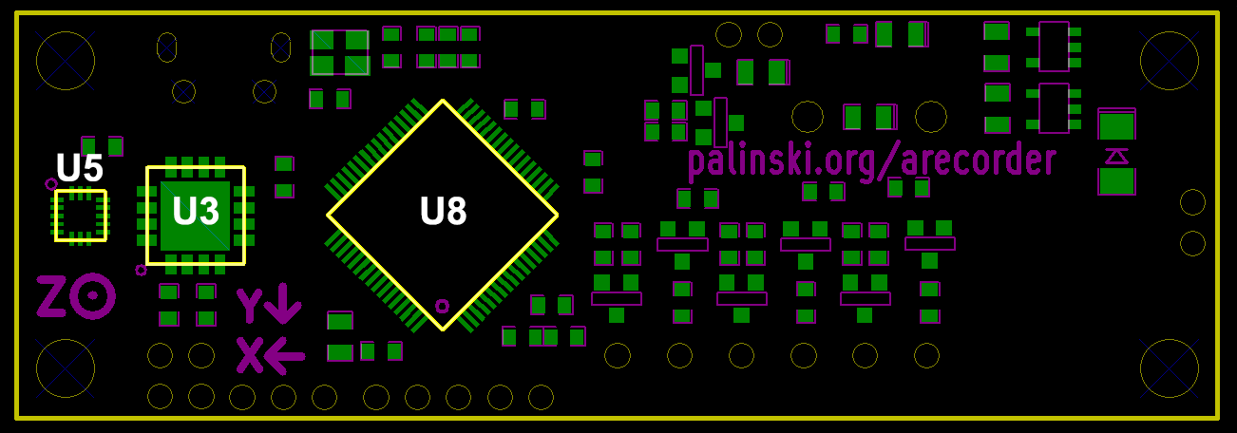
[picture p26: figure]

Rysunek 6.3: Połozenie wa ˙ | zniejszych elementów na stronie dolnej Arecordera. ˙

U3 - akcelerometr ±80 g,

U5 - akcelerometr ±24 g,

U8 - mikrokontroler.

## 7. F.A.Q. - Najczęsciej zadawane pytania ´

Czy trzeba izolowac komorę, w której znajduje się Arecorder, od przedziału ´

spadochronowego?

Nie jest to konieczne. Wysokosć maksymalna jest zapisywana przed ´

wyzwoleniem zapalnika i zmiana cisnienia spowodowana wyzwoleniem ´
zapalnika nie zmieni tej wartosci. Zaleca się jednak ´ | ze izolowanie komory ˙
Arecordera od przedziału spadochronowego, gdyz mo ˙ | ze to zaburza ˙ | c działanie ´

algorytmu awaryjnego wyzwalania spadochronu głównego i, na małych

wysokosciach, przedwczesne wyzwolenie spadochronu głównego. ´

Czy zostan ą zapisane jakies dane je ´ | sli podczas lotu rakiety nast ąpi katastrofa ´

i Arecorder ulegnie zniszczeniu?

Tak. Arecorder zapisuje dane na kartę SD co 200 ms. Jesli podczas lotu ´ Arecorder ulegnie zniszczeniu, to (zakładaj ąc, ze karta micro SD ocaleje) ˙

zostan ą zapisane wszystkie dane oprócz ostatnich 200 — 800 ms.

Czy przed lotem rakiety trzeba specjalnie przygotowac Arecorder do lotu ´

czy wystarczy go po prostu włozy˙ c do rakiety? ´
Wystarczy po prostu włozy˙ c Arecorder do rakiety tak, aby był skierowany ´

własciw ą stron ą w kierunku głowicy i był sztywno przymocowany do rakiety. ´
Zaleca się jednakze po ka ˙ | zdorazowym locie skopiowa ˙ | c dane pomiarowe ´
z karty SD i sformatowac kartę SD. Przed ka ´ | zdym lotem nale ˙ | zy równie ˙ | z˙
upewnic się, ´ | ze bateria podł ączona do Arecordera jest naładowana. ˙
Jesli nie chcę podł ącza ´ | c zapalników do Arecordera, to czy w ich miejsce mu- ´
szę podł ączyc jakie ´ | s obci ą ´ | zenie? ˙
Nie. Jesli zapalniki nie zostan ą podł ączone do Arecordera to tu ´ | z po wł ączeniu ˙

zasygnalizuje on brak zapalników. Niezaleznie od tego czy zapalniki zostały ˙

wykryte czy nie Arecorder i tak podejmie próbę odpalenia ich w odpowied-

nim momencie (zabezpieczenie na wypadek ewentualnego błędnego wykrycia

zapalnika). Jesli nie będzie zapalników impuls elektryczny nie zostanie wy- ´

zwolony. Arecorder nie wykrywa czy zapalnik faktycznie został odpalony (a więc równiez czy w trakcie odpalenia zapalnik był podł ączony), zapisywany ˙

ROZDZIAŁ 7. F.A.Q. - NAJCZ ĘSCIEJ ZADAWANE PYTANIA ´

jest jedynie moment w czasie, gdy Arecorder wyzwala impuls odpalaj ący za-

palnik.

## A. Słownik pojęc´

Pułap
Punkt lotu rakiety o najwyzszej wysoko ˙ | sci. ´

Os rakiety ´

Prosta przechodz ąca od czubka głowicy do srodka podstawy rakiety. W tej osi ´

silnik rakiety wytwarza ci ąg. W tej instrukcji poprzez termin “przyspieszenie

rakiety” będzie rozumiane przyspieszenie w osi rakiety.

K ąt pochylenia rakiety

Najmniejszy k ąt, jaki tworzy os rakiety z płaszczyzn ą prostopadł ą do lokalnego ´

pionu.


Rysunek A.1: Wizualizacja k ąta pochylenia rakiety - α. x to os rakiety, natomiast ´

g to lokalny pion.

Wysokosć względna ´

Wysokosć nad poziomem terenu. To jest wysoko ´ | sć najbardziej interesuj ąca dla ´
uzytkownika. W dalszej czę ˙ | sci instrukcji poprzez termin “wysoko ´ | sć” będzie ´

rozumiana wysokosć względna. ´

Wysokosć bezwzględna ´

Wysokosć nad poziomem morza. ´

Cisnienie odniesienia ´
To jest cisnienie pomierzone na wyrzutni; jest ono u ´ | zywane przez Arecorder ˙
do wyliczenia wysokosci bezwzględnej wyrzutni. Wysoko ´ | sć bezwzględna ´

DODATEK A. SŁOWNIK POJ ĘC´

wyrzutni będzie odejmowana od wyliczonej wysokosci bezwzględnej rakiety, ´

aby uzyskac wysoko ´ | sć względn ą, na jak ą wzniosła się rakieta. ´


Rysunek A.2: Wizualizacja zalezno ˙ sci ci ´ | snienia i wysoko ´ | sć.´ pMSL to cisnienie ´

na poziomie morza (101,325 kPa), pl
to cisnienie na poziomie wyrzutni (ci ´ | snienie ´

odniesienia), z którego jest wyliczana hl

, wysokosć bezwzględna wyrzutni. ´ | pr

to cisnienie powietrza pomierzone przez Arecorder podczas lotu rakiety; z tego ´

cisnienia jest wyliczana wysoko ´ | sć bezwzględna rakiety ( ´ | har).

## B. Siły działaj ące na rakietę

B.1. Siły działaj ące na rakietę w czasie postoju na wyrzutni


Rysunek B.1: Siły działaj ące na rakietę w czasie postoju na wyrzutni.

gdzie:
−→F g - siła grawitacji,
−→F gk
- składowa siły grawitacji równoległa do osi rakiety, −→F g⊥ - składowa siły grawitacji prostopadła do osi rakiety,

α - k ąt pochyłu rakiety.

Gdy rakieta stoi na ziemi działa na ni ą tylko siła grawitacji. Poniewaz przyspie- ˙

szenia mierzone przez akcelerometry s ą proporcjonalne do składowych sił grawi-

tacji prostopadłych i równoległych do (por. wzory B.1, B.2 i B.3), Arecorder jest

w stanie obliczyc k ąt pochylenia rakiety korzystaj ąc ze wzoru B.4 lub B.5. ´

−→a gk =

−→F gk

m

(B.1)

DODATEK B. SIŁY DZIAŁAJ ĄCE NA RAKIET Ę

−→a g⊥ =

−→F g⊥

m

(B.2)

−→a g =

−→F g

m

(B.3)

gdzie:
−→a g - przyspieszenie grawitacyjne, −→a gk
- składowa przyspieszenia grawitacyjnego prostopadła do osi rakiety, −→a g⊥ - składowa przyspieszenia grawitacyjnego rów-

noległa do osi rakiety,

−→F g - siła grawitacyjna,

−→F gk
- składowa siły grawitacyjnej

prostopadła do osi rakiety,

−→F g⊥ - składowa siły grawitacyjnej równoległa do osi

rakiety, m - masa rakiety.

cos(α) = k

−→a g⊥k

k

−→a gk

(B.4)

lub

sin(α) =

k

−→a gkk

k

−→a gk

(B.5)

B.2. Siły działaj ące na rakietę w czasie lotu

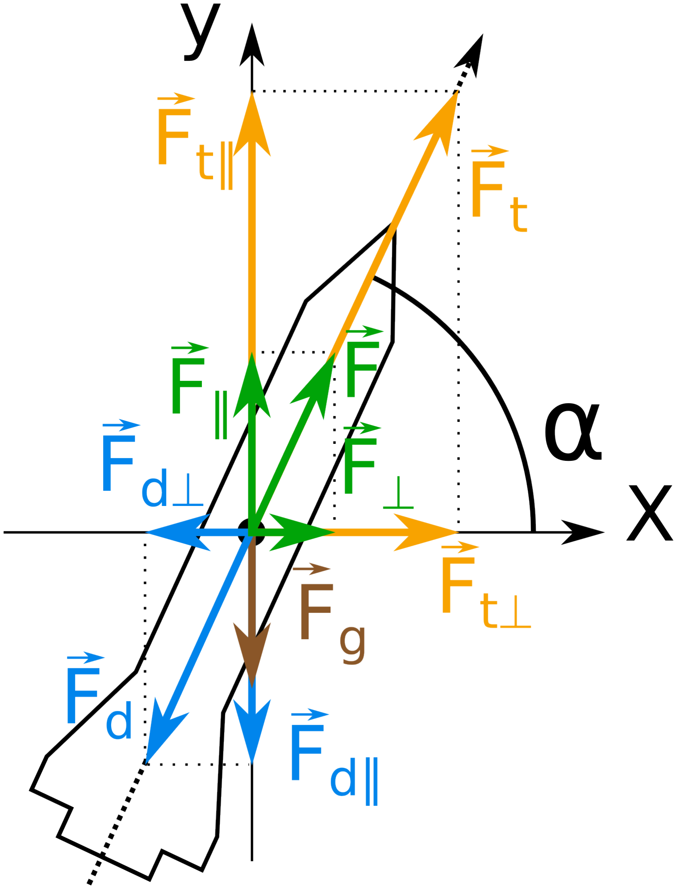
[picture p27: figure]

Rysunek B.2: Siły działaj ące na rakietę w czasie lotu

gdzie:
−→F t - siła ci ągu rakiety,

DODATEK B. SIŁY DZIAŁAJ ĄCE NA RAKIET Ę

−→F d - siła oporów aerodynamicznych,

−→F g - siła grawitacji,
−→F =

−→F d +

−→F t - siła wypadkowa ci ągu rakiety i oporów aerodynamicznych, −→F tk
,

−→F dk
,

−→F k
- składowe pionowe sił,
−→F t⊥,

−→F d⊥,

−→F ⊥ - składowe poziome sił.

α - k ąt pochyłu rakiety w czasie lotu.

Istniej ą trzy zasadnicze siły działaj ące na rakietę w czasie lotu - siła ci ągu

−→F t
,

siła oporu aerodynamicznego

−→F d oraz siła grawitacji

−→F g, co pokazane jest na

rysunku B.2. Siła ci ągu i siła oporu aerodynamicznego maj ą ten sam kierunek, ale przeciwny zwrot; działaj ą zawsze wzdłuz osi rakiety. Siła grawitacji jest zawsze ˙

równoległa do lokalnego pionu, skierowana w kierunku ziemi.

Przyspieszenie mierzone przez akcelerometry w czasie lotu jest proporcjonalne

do siły wypadkowej ci ągu rakiety i oporów aerodynamicznych.

a =

k

−→F k

m

(B.6)

Akcelerometry nie s ą w stanie pomierzyc przyspieszenia grawitacyjnego, gdy ´ | z˙
w rzeczywistosci akcelerometry scalone mierz ą jedynie ró ´ | znicę pomiędzy przy- ˙

spieszeniem działaj ącym na obudowę akcelerometru a przyspieszeniem działaj ą-

cym na strukturę wewn ątrz akcelerometru - grawitacja działa na całosć akcelero- ´
metru, więc nie wytwarza zadnej ró ˙ | znicy przyspiesze ˙ | n (w czasie postoju na wy- ´
rzutni akcelerometry mierz ą w rzeczywistosci siłę wywieran ą przez podło ´ | ze na ˙

rakietę, przeciwdziałaj ąc ą grawitacji). Działanie grawitacji jest aproksymowane
przez załozenie, ˙ | ze na maksymalnej wysoko ˙ | sci działania Arecordera przyspiesze- ´

nie grawitacyjne jest w przyblizeniu równe przyspieszeniu grawitacyjnemu przy ˙ powierzchni ziemi i wynosi 9,81 m
s

2 .

W czasie lotu przyspieszenie poziome i pionowe jest wyliczane z przyspieszenia wzdłuz osi rakiety dodaj ąc korektę na przyspieszenie grawitacyjne w przy- ˙

padku przyspieszenia pionowego.

ak = a sin α − g | (B.7)

gdzie:

ak
- przyspieszenie pionowe,
a - przyspieszenie wzdłuz osi rakiety, ˙

α - k ąt pochyłu rakiety w czasie lotu, g - przyspieszenie grawitacyjne (9,81 m
s

2 ).

a⊥ = a cos α | (B.8)

DODATEK B. SIŁY DZIAŁAJ ĄCE NA RAKIET Ę

gdzie:

ak
- przyspieszenie poziome,
a - przyspieszenie wzdłuz osi rakiety, ˙

α - k ąt pochyłu rakiety w czasie lotu.

Arecorder liczy prędkosć w składowej pionowej (czyli prędko ´ | sć wznoszenia ´

się rakiety) i składowej poziomej (czyli prędkosć lotu na zasięg) zgodnie ze wzo- ´
rami odpowiednio B.9 i B.10. Prędkosci pionowe i poziome s ą w ka ´ | zdej jednostce ˙

czasu aktualizowane o wyliczon ą zmianę - prędkosci składowe s ą sum ą wszystkich ´

zmian od chwili startu rakiety.

4Vk = ak4t | (B.9)

gdzie:
4Vk
- zmiana prędkosci pionowej w jednostce czasu, ´

ak
- przyspieszenie pionowe,
4t - zmiana w czasie pomiędzy kolejnymi aktualizacjami prędkosci (10 ms). ´
4V⊥ = a⊥4t | (B.10)

gdzie:
4V⊥ - zmiana prędkosci poziomej w jednostce czasu, ´

a⊥ - przyspieszenie poziome,
4t - zmiana w czasie pomiędzy kolejnymi aktualizacjami prędkosci (10 ms). ´

Prędkosć w osi rakiety jest wyliczana ze składowych pionowych i poziomych ´

prędkosci zgodnie ze wzorem B.11. ´

V =

q
V

2
k + V

2
⊥

(B.11)

gdzie:
V - prędkosć w osi rakiety, ´

Vk
- składowa pionowa prędkosci, ´

V⊥ - składowa pozioma prędkosci. ´

Natomiast k ąt pochyłu rakiety jest wyliczany w oparciu o zaktualizowane skła-

dowe prędkosci, zgodnie ze wzorem B.12. ´

α = arccos(V⊥
V
) | (B.12)

gdzie:
α - k ąt pochyłu rakiety,

V⊥ - składowa pozioma prędkosci, ´

V - prędkosć w osi rakiety. ´

## C. Historia zmian

2013.09.18

— Pierwsze wydanie instrukcji.

2013.09.25

— Dodana historia zmian.

— Dodane wartosci poboru pr ądu przez Arecorder. ´

— Dodanie informacji o zaleceniu odczekania dwóch minut po wł ączeniu

Arecordera przed startem rakiety w celu ustabilizowania wskazan czujnika ´

cisnienia oraz o sposobie skompensowania błędu w przypadku lotu z ´

nieustabilizowanym czujnikiem.

2013.12.27

— Dodana instrukcja wkładania i wyjmowania karty SD,

— Dodany słownik pojęc,´

— Uaktualnienie instrukcji do najnowszej wersji oprogramowania Arecor-

dera,
— Dodane wymiarowanie Arecordera wraz z połozeniami wa ˙ | zniejszych ele- ˙

mentów na płycie drukowanej,

— Dodane wiele rysunków,

— Dodane nowe pytania do F.A.Q,

— Dodany zał ącznik o siłach działaj ących na rakietę i sposobie obliczania

prędkosci rakiety. ´

2014.03.16

— Dodano sekcję 3.1.4 o sposobie konwersji surowych danych z akcelerome-
trów na wartosci wyra ´ | zone w [g] i [ ˙ | m s 2 ].

DODATEK C. HISTORIA ZMIAN

2015.05.03

— Uaktualniono instrukcję dla Arecordera w wersji 2.1.

2015.05.04

— Dodano tabelę domyslnych warto ´ | sci programów Arecordera. ´

2016.06.05

— Zmieniono informację o programowaniu Arecordera - teraz programowanie

dokonuje się poprzez zł ącze USB,

— Uaktualniono nagłówek danych w 3,
— Dodano informację o mozliwo ˙ | sci programowania prędko ´ | sci opadania, przy ´

której zadziała algorytm awaryjnego wyzwalania spadochronu pilota a
takze informację o mo ˙ | zliwo ˙ | sci jego wył ączenia, ´
— Dodano do tabeli domyslnych warto ´ | sci 2.3 parametr prędko ´ | sci opadania ´

rakiety, przy której zostanie awaryjnie wyzwolony spadochron główny,
— Dodano informację o mozliwo ˙ sci wznawiania przez Arecorder zapisu na ´

kartę SD w przypadku tymczasowej utraty fizycznego kontaktu z kart ą,

— Uaktualniono pobór pr ądu w tabeli 5.2,

— Zmieniono wymiarowanie do Arecordera w wersji 2.2.
