PTR-projects/PTR_arecorder/tools/Areconfig_rebuild/source/Areconfig_rebuild_0_1/img/Arecorder_cal_Zn.jpg

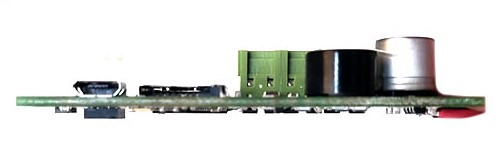
tools/Areconfig_rebuild/source/Areconfig_rebuild_0_1/img/Arecorder_cal_Zn.jpg
