PTR-projects/PTR_arecorder/tools/Areconfig_rebuild/source/Areconfig_rebuild_0_1/img/Rocket simple.png

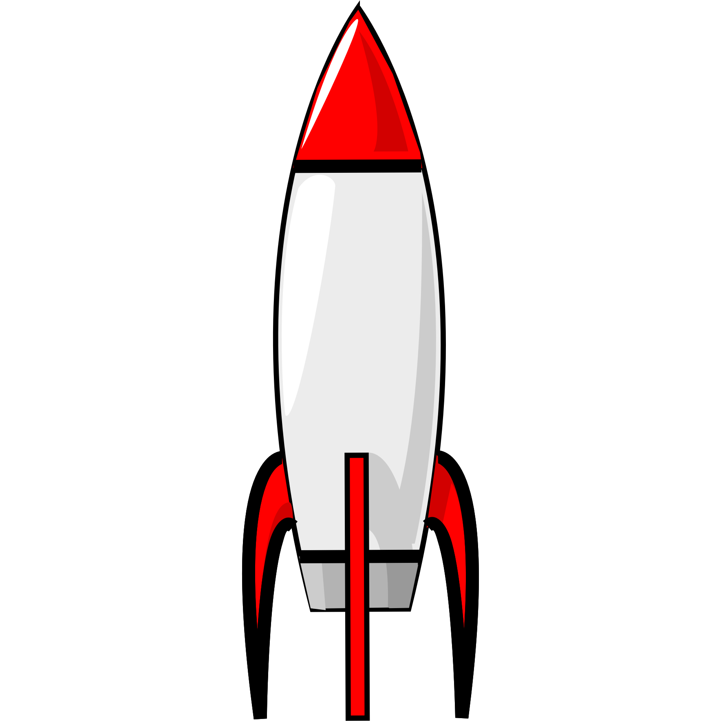
tools/Areconfig_rebuild/source/Areconfig_rebuild_0_1/img/Rocket simple.png
