PTR-projects/PTR_arecorder/hardware/kicad/Arecorder v2.2.pdf

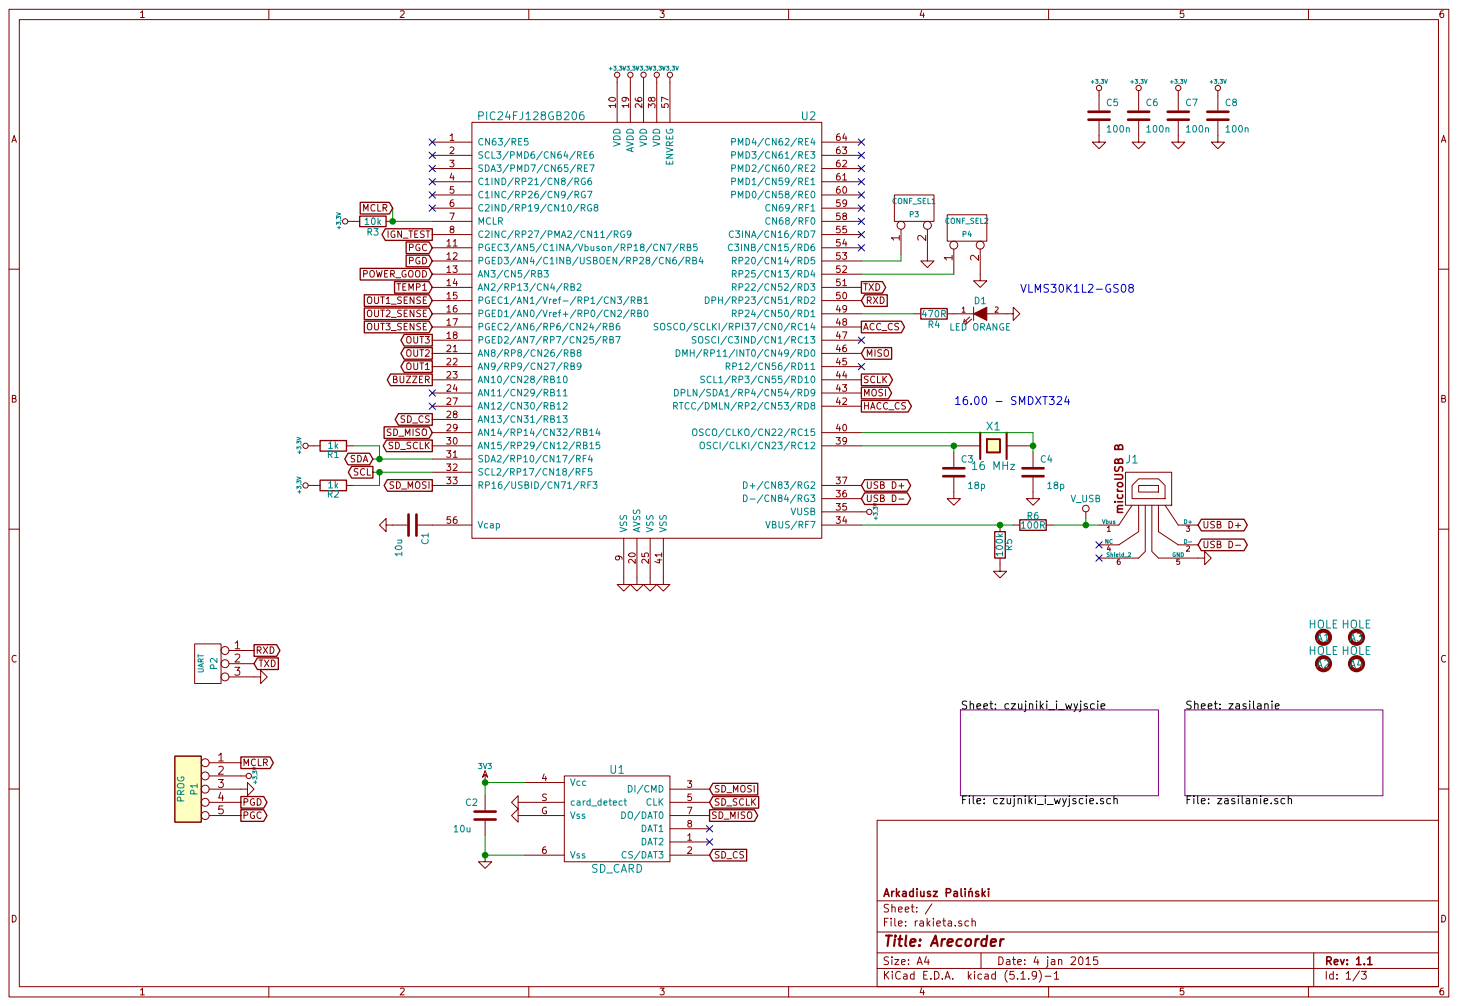
[picture p33: page 1]

Id: 1/3 Title: Arecorder File: rakieta.sch Sheet: / Arkadiusz Paliski Sheet: czujniki_i_wyjscie

Sheet: zasilanie File: zasilanie.sch

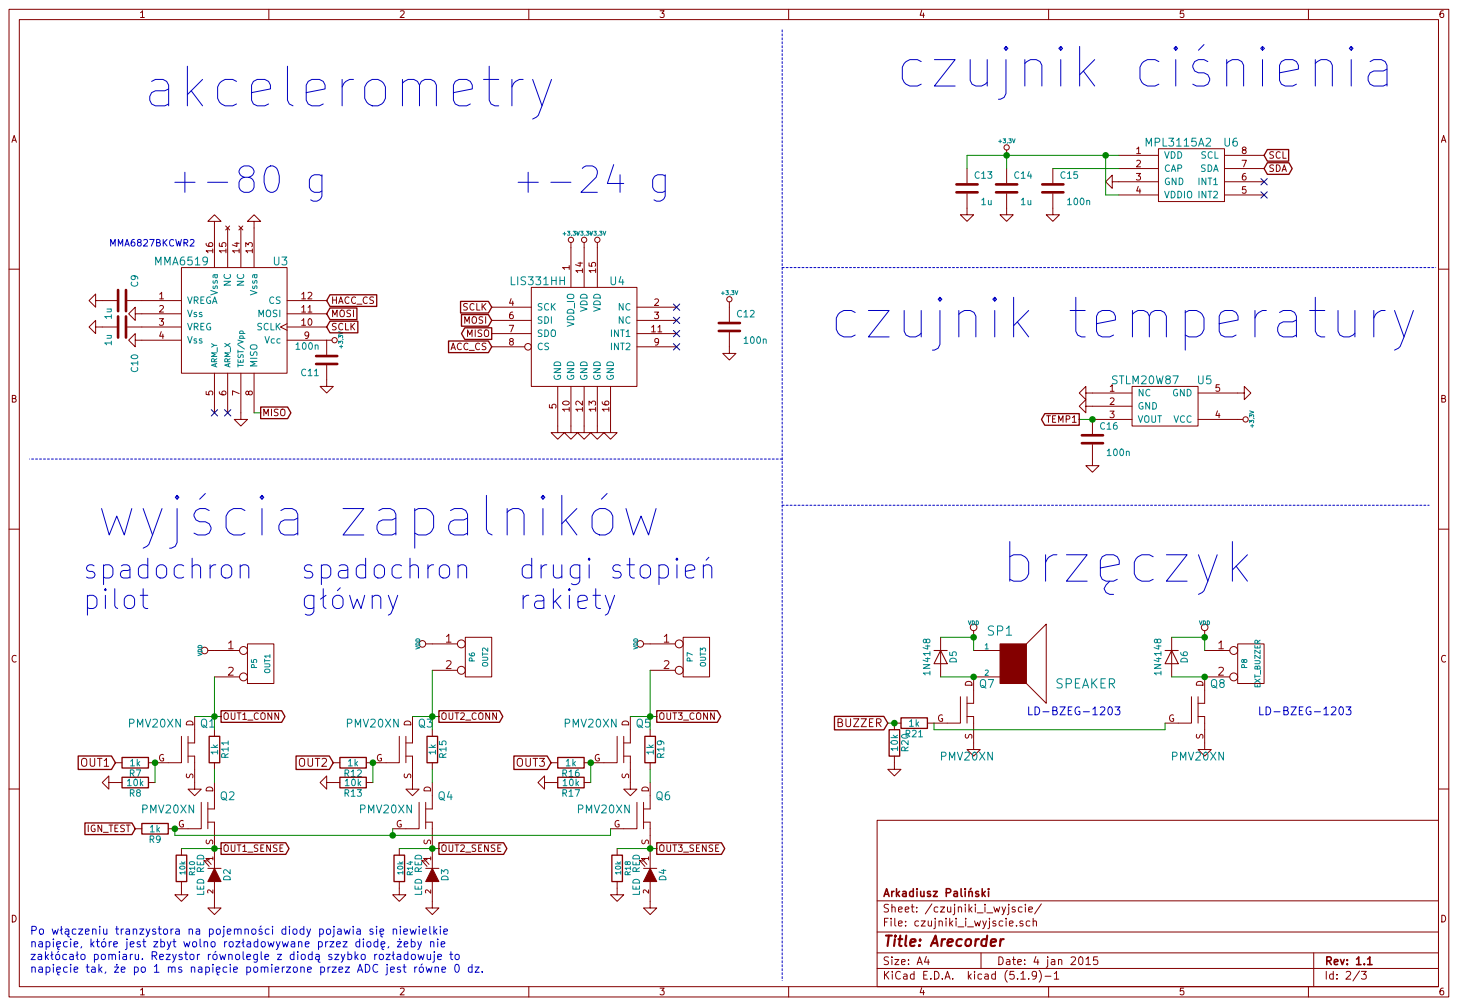
[picture p34: page 2]

1 2 D2 LED RED1 2 D3 LED RED1 2 D4 LED RED D5 1N4148

Po wczeniu tranzystora na pojemnoci diody pojawia si niewielkie
napicie, które jest zbyt wolno rozadowywane przez diod, eby nie
zakócao pomiaru. Rezystor równolegle z diod szybko rozadowuje to
napicie tak, e po 1 ms napicie pomierzone przez ADC jest równe 0 dz.

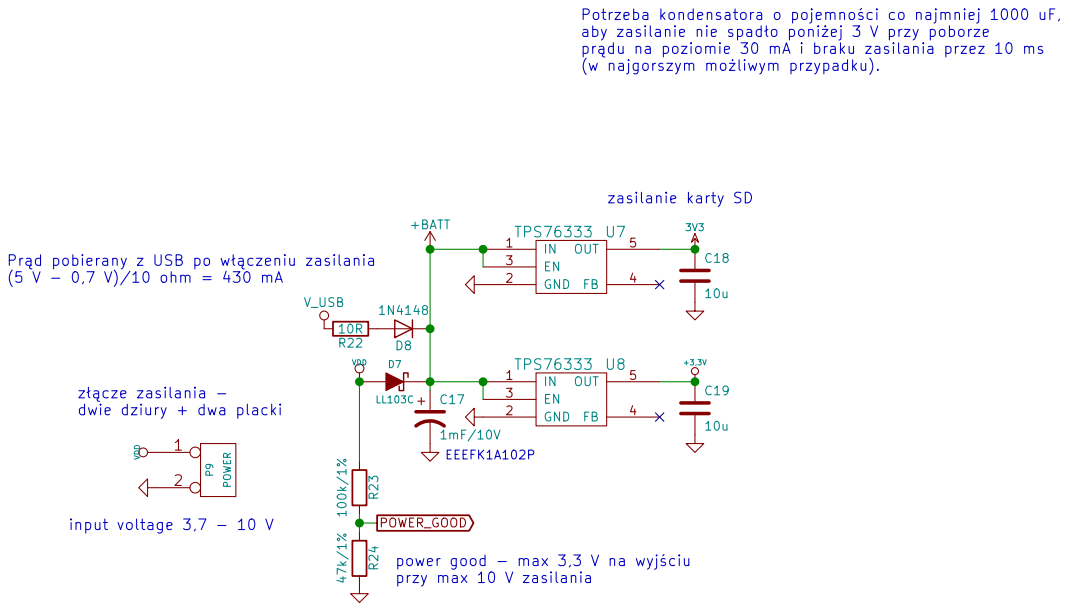
[picture p35: page 3]

Potrzeba kondensatora o pojemnoci co najmniej 1000 uF,
aby zasilanie nie spado poniej 3 V przy poborze
prdu na poziomie 30 mA i braku zasilania przez 10 ms

Id: 3/3 Title: Arecorder File: zasilanie.sch Sheet: /zasilanie/ Arkadiusz Paliski
