PTR-projects/PTR_arecorder/hardware/kicad/rakieta.kicad_pcb

## KiCad design hardware/kicad/rakieta.kicad_pcb (2026-09-05)

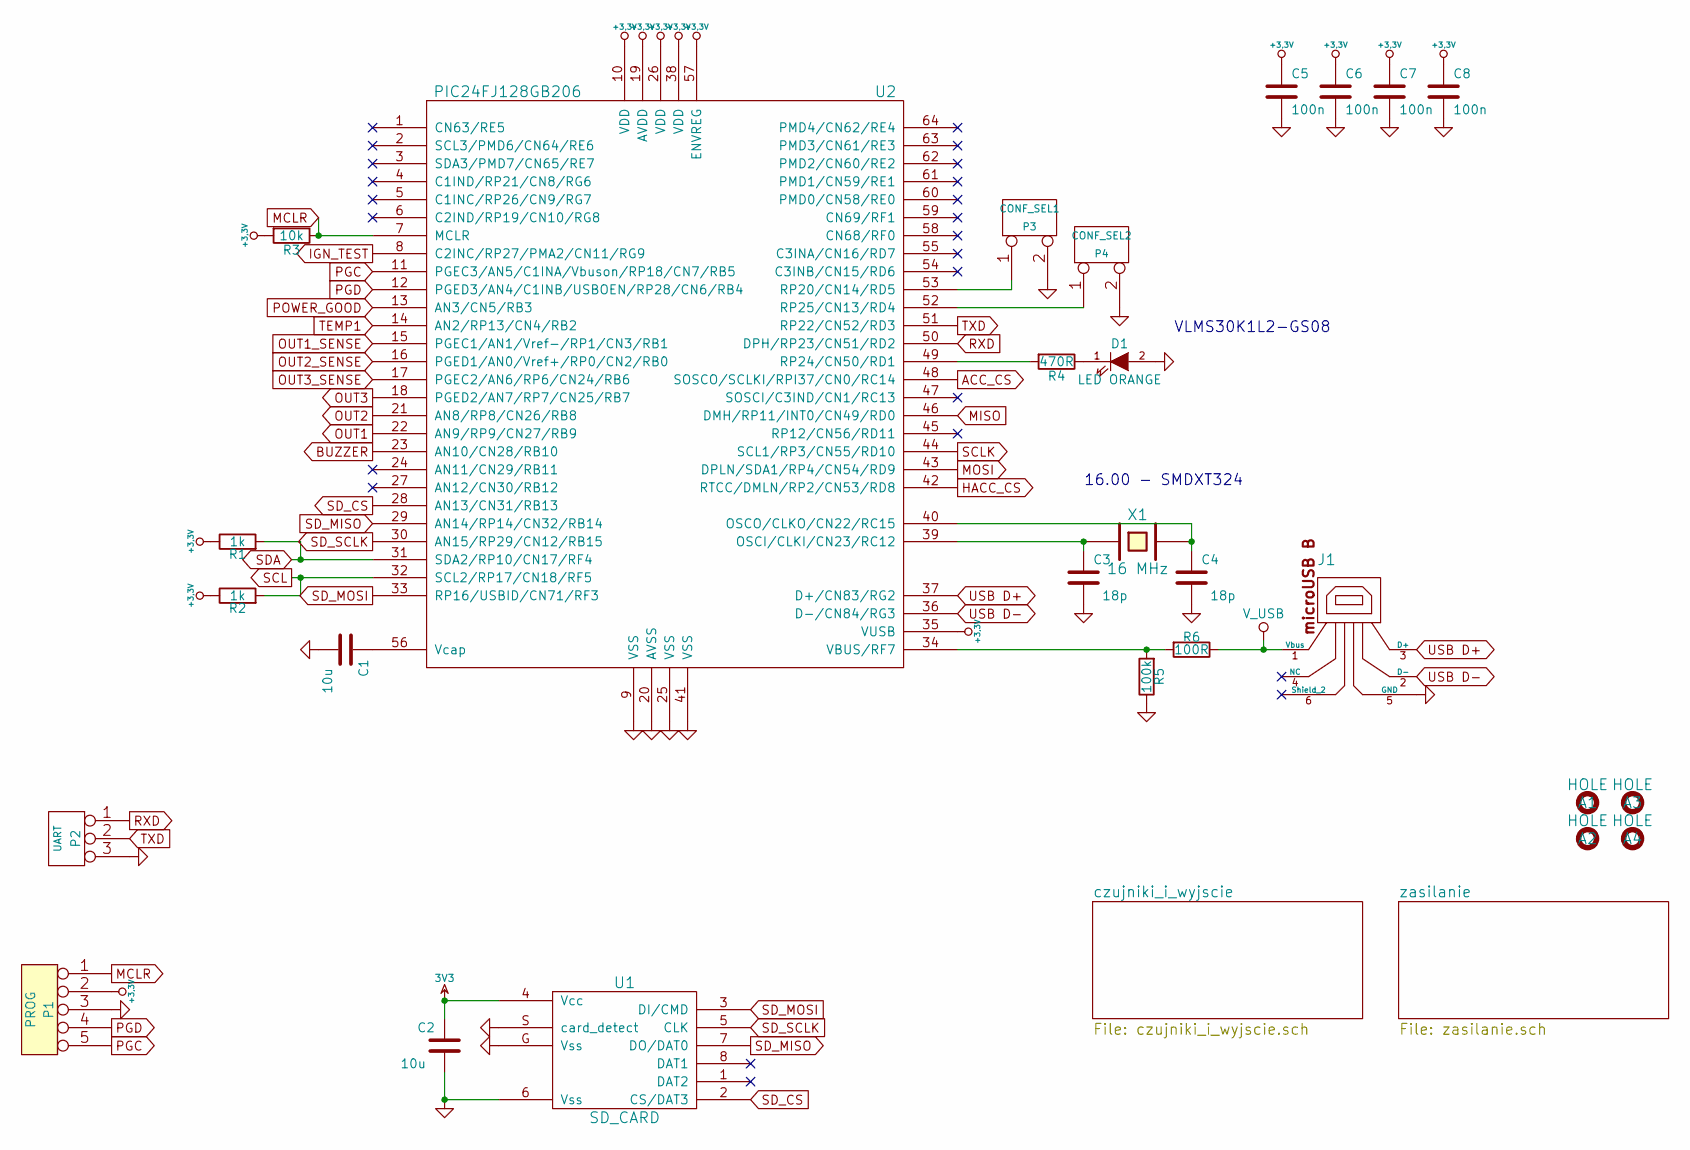
[picture p36: schematic rakieta.sch, Arecorder]

Parts:
A1, A2, A3, A4: HOLE; HOLE_3mm
C1, C2: 10u; SM0805
C3, C4: 18p; SM0603
C5, C6, C7, C8: 100n; SM0603
D1: LED ORANGE; SM1210_DIODE
J1: USB_B_micro; USB_MICRO
P1: PROG; conn_goldpin_5
P2: UART; conn_goldpin_3
P3: CONF_SEL1; conn_goldpin_2
P4: CONF_SEL2; conn_goldpin_2
R1, R2: 1k; SM0603
R3: 10k; SM0603
R4: 470R; SM0603
R5: 100k; SM0603
R6: 100R; SM0603
U1: SD_CARD; MICRO_SD_CARD_SLOT
U2: PIC24FJ128GB206; TQFP_64
X1: 16 MHz; HC-3.4x2.7

Connections:
3V3: C2.1, U1.4 (Vcc); also elsewhere on the board
+3.3V: C5.1, C6.1, C7.1, C8.1, P1.2, R1.1, R2.1, R3.2, U2.10 (VDD), U2.19 (AVDD), U2.26 (VDD), U2.35 (VUSB), U2.38 (VDD), U2.57 (ENVREG); also elsewhere on the board
ACC_CS: U2.48 (SOSCO/SCLKI/RPI37/CN0/RC14); also elsewhere on the board
BUZZER: U2.23 (AN10/CN28/RB10); also elsewhere on the board
GND: C1.2, C2.2, C3.2, C4.2, C5.2, C6.2, C7.2, C8.2, D1.2 (A), J1.5 (GND), P1.3, P2.3, P3.2 (PM), P4.2 (PM), R5.1, U1.6 (Vss), U1.G (Vss), U1.S (card_detect), U2.9 (VSS), U2.20 (AVSS), U2.25 (VSS), U2.41 (VSS); also elsewhere on the board
HACC_CS: U2.42 (RTCC/DMLN/RP2/CN53/RD8); also elsewhere on the board
IGN_TEST: U2.8 (C2INC/RP27/PMA2/CN11/RG9); also elsewhere on the board
MCLR: P1.1, R3.1, U2.7 (MCLR)
MISO: U2.46 (DMH/RP11/INT0/CN49/RD0); also elsewhere on the board
MOSI: U2.43 (DPLN/SDA1/RP4/CN54/RD9); also elsewhere on the board
unnamed: C1.1, U2.56 (Vcap)
unnamed: C3.1, U2.39 (OSCI/CLKI/CN23/RC12), X1.1
unnamed: C4.1, U2.40 (OSCO/CLKO/CN22/RC15), X1.2
unnamed: D1.1 (K), R4.1
unnamed: P3.1, U2.53 (RP20/CN14/RD5)
unnamed: P4.1, U2.52 (RP25/CN13/RD4)
unnamed: R4.2, U2.49 (RP24/CN50/RD1)
unnamed: R5.2, R6.2, U2.34 (VBUS/RF7)
OUT1: U2.22 (AN9/RP9/CN27/RB9); also elsewhere on the board
OUT1_SENSE: U2.15 (PGEC1/AN1/Vref-/RP1/CN3/RB1); also elsewhere on the board
OUT2: U2.21 (AN8/RP8/CN26/RB8); also elsewhere on the board
OUT2_SENSE: U2.16 (PGED1/AN0/Vref+/RP0/CN2/RB0); also elsewhere on the board
OUT3: U2.18 (PGED2/AN7/RP7/CN25/RB7); also elsewhere on the board
OUT3_SENSE: U2.17 (PGEC2/AN6/RP6/CN24/RB6); also elsewhere on the board
PGC: P1.5, U2.11 (PGEC3/AN5/C1INA/Vbuson/RP18/CN7/RB5)
PGD: P1.4, U2.12 (PGED3/AN4/C1INB/USBOEN/RP28/CN6/RB4)
POWER_GOOD: U2.13 (AN3/CN5/RB3); also elsewhere on the board
RXD: P2.1, U2.50 (DPH/RP23/CN51/RD2)
SCL: R2.2, U2.32 (SCL2/RP17/CN18/RF5); also elsewhere on the board
SCLK: U2.44 (SCL1/RP3/CN55/RD10); also elsewhere on the board
SDA: R1.2, U2.31 (SDA2/RP10/CN17/RF4); also elsewhere on the board
SD_CS: U1.2 (CS/DAT3), U2.28 (AN13/CN31/RB13)
SD_MISO: U1.7 (DO/DAT0), U2.29 (AN14/RP14/CN32/RB14)
SD_MOSI: U1.3 (DI/CMD), U2.33 (RP16/USBID/CN71/RF3)
SD_SCLK: U1.5 (CLK), U2.30 (AN15/RP29/CN12/RB15)
TEMP1: U2.14 (AN2/RP13/CN4/RB2); also elsewhere on the board
TXD: P2.2 (PM), U2.51 (RP22/CN52/RD3)
USB D+: J1.3 (D+), U2.37 (D+/CN83/RG2)
USB D-: J1.2 (D-), U2.36 (D-/CN84/RG3)
V_USB: J1.1 (Vbus), R6.1; also elsewhere on the board

Notes on the sheet:
16.00 - SMDXT324
VLMS30K1L2-GS08

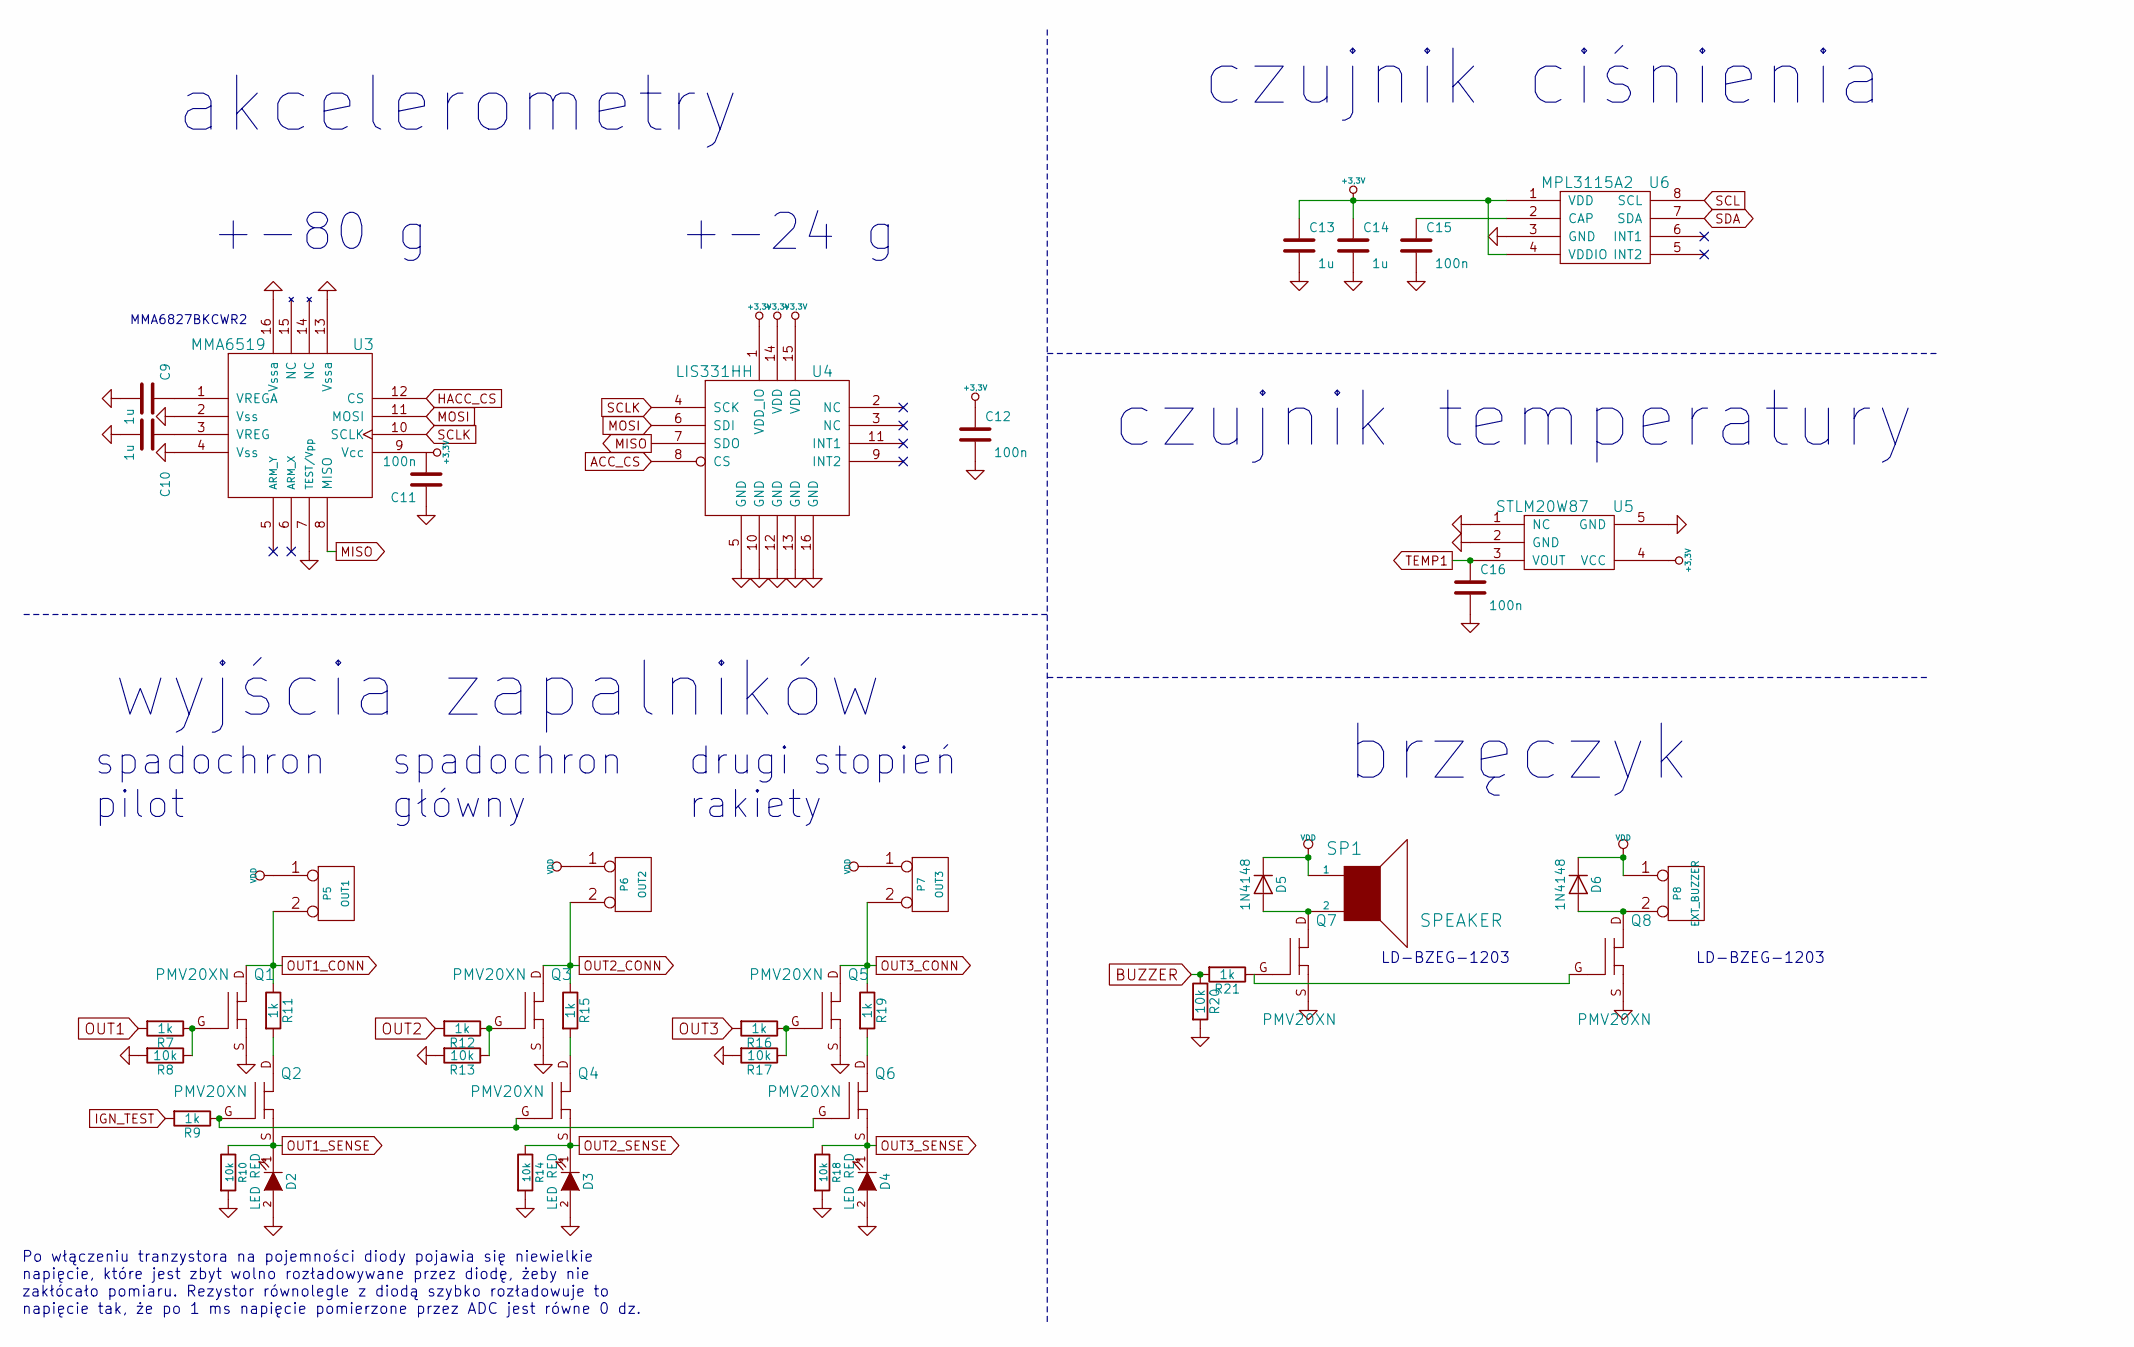
[picture p37: schematic czujniki_i_wyjscie.sch, Arecorder]

Parts:
C9, C10: 1u; SM0603
C11, C12, C16: 100n; SM0603
C13, C14: 1u; C_0603_1608Metric
C15: 100n; C_0603_1608Metric
D2, D3, D4: LED RED; SM1210_DIODE
D5, D6: 1N4148; SM0805_DIODE
P5: OUT1; conn_ark_2_3.81
P6: OUT2; conn_ark_2_3.81
P7: OUT3; conn_ark_2_3.81
P8: EXT_BUZZER; conn_goldpin_2
Q1, Q2, Q3, Q4, Q5, Q6, Q7, Q8: PMV20XN; SOT23GDS
R7, R9, R11, R12, R15, R16, R19, R21: 1k; SM0603
R8, R10, R13, R14, R17, R18, R20: 10k; SM0603
SP1: SPEAKER; buzzer_12mm
U3: MMA6519; QFN16
U4: LIS331HH; LGA16
U5: STLM20W87; SOT323-5L
U6: MPL3115A2; LGA8_3x5

Connections:
+3.3V: C11.2, C12.1, C13.1, C14.1, U3.9 (Vcc), U4.1 (VDD_IO), U4.14 (VDD), U4.15 (VDD), U5.4 (VCC), U6.1 (VDD), U6.4 (VDDIO); also elsewhere on the board
ACC_CS: U4.8 (CS); also elsewhere on the board
BUZZER: R20.1, R21.2; also elsewhere on the board
GND: C9.2, C10.2, C11.1, C12.2, C13.2, C14.2, C15.2, C16.2, D2.2 (A), D3.2 (A), D4.2 (A), Q1.S, Q3.S, Q5.S, Q7.S, Q8.S, R8.2, R10.2, R13.2, R14.2, R17.2, R18.2, R20.2, U3.2 (Vss), U3.4 (Vss), U3.7 (TEST/Vpp), U3.13 (Vssa), U3.16 (Vssa), U4.5 (GND), U4.10 (GND), U4.12 (GND), U4.13 (GND), U4.16 (GND), U5.1 (NC), U5.2 (GND), U5.5 (GND), U6.3 (GND); also elsewhere on the board
HACC_CS: U3.12 (CS); also elsewhere on the board
IGN_TEST: R9.2; also elsewhere on the board
MISO: U3.8 (MISO), U4.7 (SDO); also elsewhere on the board
MOSI: U3.11 (MOSI), U4.6 (SDI); also elsewhere on the board
unnamed: C9.1, U3.1 (VREGA)
unnamed: C10.1, U3.3 (VREG)
unnamed: C15.1, U6.2 (CAP)
unnamed: D5.2 (A), Q7.D, SP1.2
unnamed: D6.2 (A), P8.2 (PM), Q8.D
unnamed: Q1.G, R7.1, R8.1
unnamed: Q2.D, R11.2
unnamed: Q2.G, Q4.G, Q6.G, R9.1
unnamed: Q3.G, R12.1, R13.1
unnamed: Q4.D, R15.2
unnamed: Q5.G, R16.1, R17.1
unnamed: Q6.D, R19.2
unnamed: Q7.G, Q8.G, R21.1
OUT1: R7.2; also elsewhere on the board
OUT1_CONN: P5.2 (PM), Q1.D, R11.1
OUT1_SENSE: D2.1 (K), Q2.S, R10.1; also elsewhere on the board
OUT2: R12.2; also elsewhere on the board
OUT2_CONN: P6.2 (PM), Q3.D, R15.1
OUT2_SENSE: D3.1 (K), Q4.S, R14.1; also elsewhere on the board
OUT3: R16.2; also elsewhere on the board
OUT3_CONN: P7.2 (PM), Q5.D, R19.1
OUT3_SENSE: D4.1 (K), Q6.S, R18.1; also elsewhere on the board
SCL: U6.8 (SCL); also elsewhere on the board
SCLK: U3.10 (SCLK), U4.4 (SCK); also elsewhere on the board
SDA: U6.7 (SDA); also elsewhere on the board
TEMP1: C16.1, U5.3 (VOUT); also elsewhere on the board
VDD: D5.1 (K), D6.1 (K), P5.1, P6.1, P7.1, P8.1, SP1.1; also elsewhere on the board

Notes on the sheet:
drugi stopień rakiety
spadochron główny
spadochron pilot
brzęczyk
czujnik temperatury
czujnik ciśnienia
+-24 g
+-80 g
akcelerometry
wyjścia zapalników
LD-BZEG-1203
Po włączeniu tranzystora na pojemności diody pojawia się niewielkie napięcie, które jest zbyt wolno rozładowywane przez diodę, żeby nie zakłócało pomiaru. Rezystor równolegle z diodą szybko rozładowuje to napięcie tak, że po 1 ms napięcie pomierzone przez ADC jest równe 0 dz.
MMA6827BKCWR2

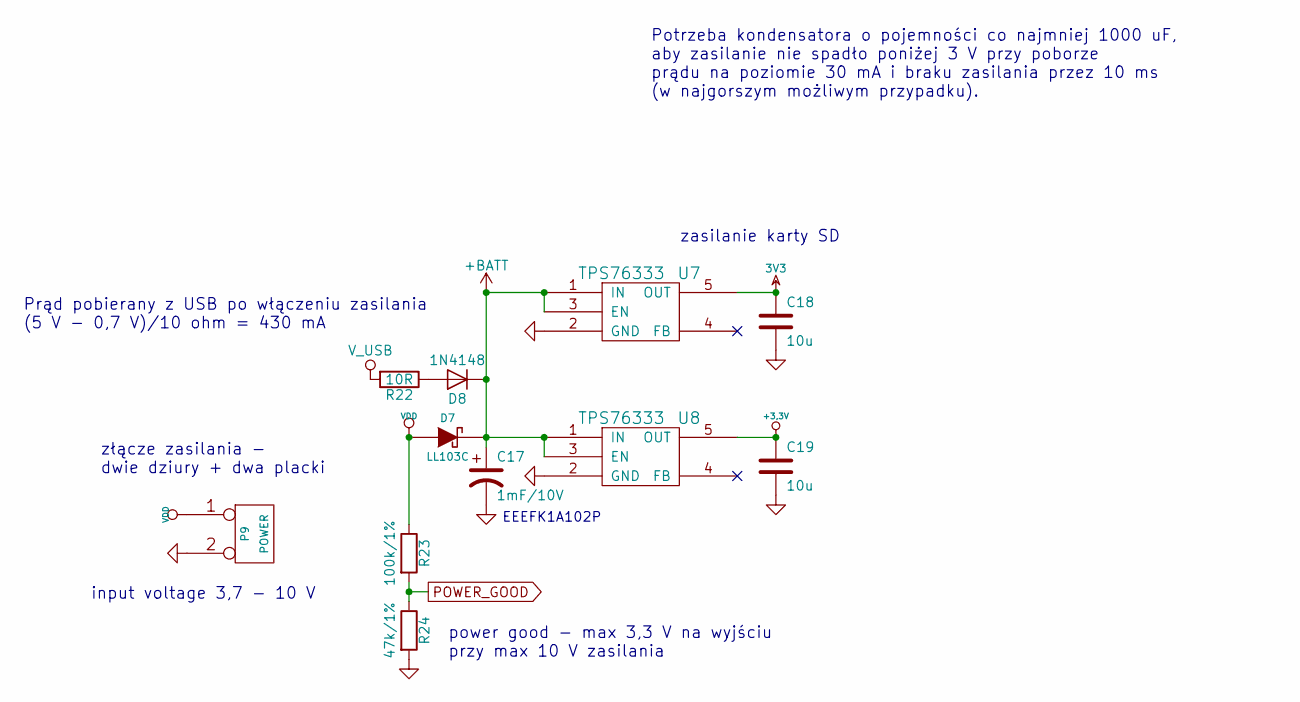
[picture p38: schematic zasilanie.sch, Arecorder]

Parts:
C17: 1mF/10V; SMD_G_cap
C18, C19: 10u; SM0805
D7: LL103C; SM1206_DIODE
D8: 1N4148; SM0805_DIODE
P9: POWER; conn_goldpin_2
R22: 10R; SM0603
R23: 100k/1%; SM0603
R24: 47k/1%; SM0603
U7, U8: TPS76333; SOT23-5

Connections:
3V3: C18.1, U7.5 (OUT); also elsewhere on the board
+3.3V: C19.1, U8.5 (OUT); also elsewhere on the board
+BATT: C17.1, D7.1 (K), D8.1 (K), U7.1 (IN), U7.3 (EN), U8.1 (IN), U8.3 (EN)
GND: C17.2, C18.2, C19.2, P9.2 (PM), R24.2, U7.2 (GND), U8.2 (GND); also elsewhere on the board
unnamed: D8.2 (A), R22.1
POWER_GOOD: R23.2, R24.1; also elsewhere on the board
VDD: D7.2 (A), P9.1, R23.1; also elsewhere on the board
V_USB: R22.2; also elsewhere on the board

Notes on the sheet:
zasilanie karty SD
Potrzeba kondensatora o pojemności co najmniej 1000 uF, aby zasilanie nie spadło poniżej 3 V przy poborze prądu na poziomie 30 mA i braku zasilania przez 10 ms (w najgorszym możliwym przypadku).
złącze zasilania - dwie dziury + dwa placki
input voltage 3,7 - 10 V
power good - max 3,3 V na wyjściu przy max 10 V zasilania
EEEFK1A102P
Prąd pobierany z USB po włączeniu zasilania (5 V - 0,7 V)/10 ohm = 430 mA

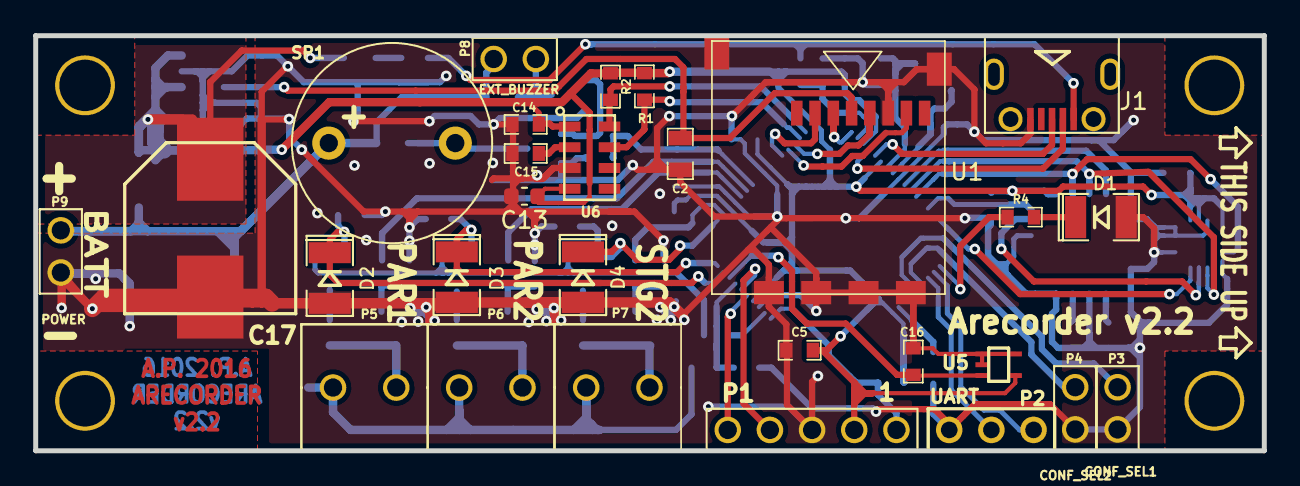
[picture p39: board rakieta.kicad_pcb from above]

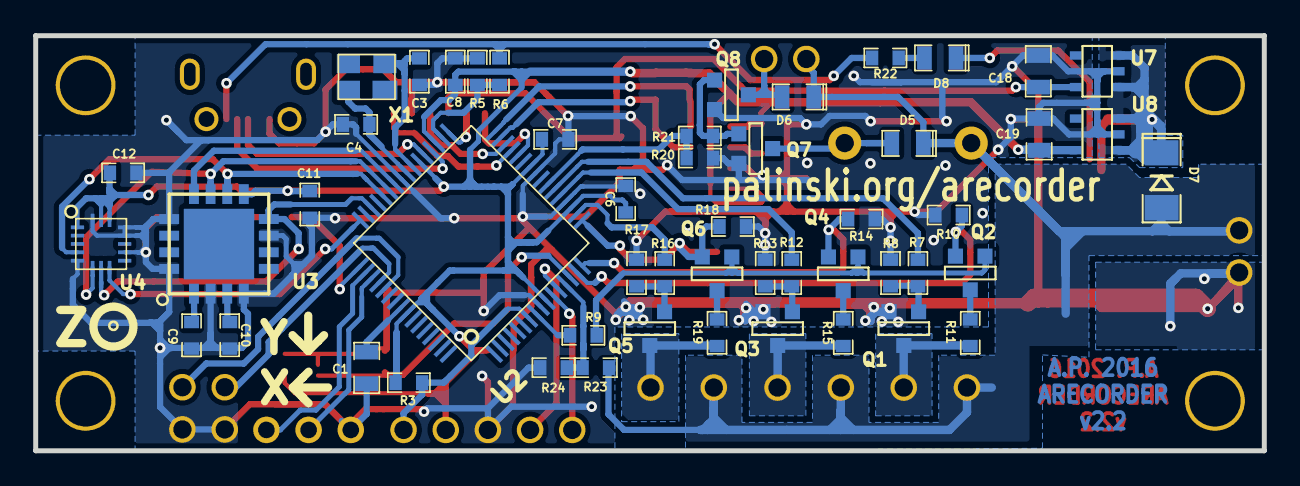
[picture p40: board rakieta.kicad_pcb from below]

Board: 2 copper layers, 74.0 x 25.0 mm, 83 parts (51 on the bottom side), 59 nets.
