PTR-projects/PTR_arecorder/firmware/current/inc/SD-SPI.h

/******************************************************************************
 *
 *                Microchip Memory Disk Drive File System
 *
 ******************************************************************************
 * FileName:        SD-SPI.h
 * Dependencies:    GenericTypeDefs.h
 *                  FSconfig.h
 *                  FSDefs.h
 * Processor:       PIC18/PIC24/dsPIC30/dsPIC33/PIC32
 * Compiler:        C18/C30/C32
 * Company:         Microchip Technology, Inc.
 * Version:         1.3.0
 *
 * Software License Agreement
 *
 * The software supplied herewith by Microchip Technology Incorporated
 * (the "Company") for its PICmicro® Microcontroller is intended and
 * supplied to you, the Company’s customer, for use solely and
 * exclusively on Microchip PICmicro Microcontroller products. The
 * software is owned by the Company and/or its supplier, and is
 * protected under applicable copyright laws. All rights are reserved.
 * Any use in violation of the foregoing restrictions may subject the
 * user to criminal sanctions under applicable laws, as well as to
 * civil liability for the breach of the terms and conditions of this
 * license.
 *
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
*****************************************************************************/

#ifndef SDMMC_H
#define SDMMC_H
#define MEDIA_SOFT_DETECT

#include "GenericTypeDefs.h"
#include "FSconfig.h"
#include "FSDefs.h"


#ifdef __18CXX
    // Description: This macro is used to initialize a PIC18 SPI module with a 4x prescale divider
    #define   SYNC_MODE_FAST    0x00
    // Description: This macro is used to initialize a PIC18 SPI module with a 16x prescale divider
    #define   SYNC_MODE_MED     0x01
    // Description: This macro is used to initialize a PIC18 SPI module with a 64x prescale divider
    #define   SYNC_MODE_SLOW    0x02
#elif defined __PIC32MX__
    // Description: This macro is used to initialize a PIC32 SPI module
    #define   SYNC_MODE_FAST    0x3E
    // Description: This macro is used to initialize a PIC32 SPI module
    #define   SYNC_MODE_SLOW    0x3C
#else
    // Description: This macro indicates the SPI enable bit for 16-bit PICs
    #ifndef MASTER_ENABLE_ON
        #define  MASTER_ENABLE_ON       0x0020
    #endif

    // Description: This macro is used to initialize a 16-bit PIC SPI module
    #ifndef SYNC_MODE_FAST
        #define   SYNC_MODE_FAST    0x3E
    #endif
    // Description: This macro is used to initialize a 16-bit PIC SPI module
    #ifndef SYNC_MODE_SLOW
        #define   SYNC_MODE_SLOW    0x3C
    #endif

    // Description: This macro is used to initialize a 16-bit PIC SPI module secondary prescaler
    #ifndef SEC_PRESCAL_1_1
        #define  SEC_PRESCAL_1_1        0x001c
    #endif
    // Description: This macro is used to initialize a 16-bit PIC SPI module primary prescaler
    #ifndef PRI_PRESCAL_1_1
        #define  PRI_PRESCAL_1_1        0x0003
    #endif
#endif



/*****************************************************************/
/*                  Strcutures and defines                       */
/*****************************************************************/


// Description: This macro represents an SD card start single data block token (used for single block writes)
#define DATA_START_TOKEN            0xFE

// Description: This macro represents an SD card start multi-block data token (used for multi-block writes)
#define DATA_START_MULTI_BLOCK_TOKEN    0xFC

// Description: This macro represents an SD card stop transmission token.  This is used when finishing a multi block write sequence.
#define DATA_STOP_TRAN_TOKEN        0xFD

// Description: This macro represents an SD card data accepted token
#define DATA_ACCEPTED               0x05

// Description: This macro indicates that the SD card expects to transmit or receive more data
#define MOREDATA    !0

// Description: This macro indicates that the SD card does not expect to transmit or receive more data
#define NODATA      0

// Description: This macro represents a floating SPI bus condition
#define MMC_FLOATING_BUS    0xFF

// Description: This macro represents a bad SD card response byte
#define MMC_BAD_RESPONSE    MMC_FLOATING_BUS

// The SDMMC Commands
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
