PTR-projects/PTR_arecorder/(commit log)

2026-07-14 Tools for Arecorder
    + AreConfig - configuration software
    + Areconfig_v2 - new C# version with additional features like calibration
    + Arecorder Meas Parser - generates Excel friendly file from flight log
2026-07-14 Hardware docs
    + PDF schematic
    + kicad project (schematic + PCB)
    + fabrication gerbers
    [arecorder_ext.kicad_pcb, arecorder_ext.sch, czujniki_i_wyjscie.sch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]
2026-07-14 Firmware added
    + current modified version
    + original version from Arecorder author
    + custom version - logger and servo/valve support
2026-09-05 Tools source code added
    [2022-12-10 LRE MEAS_przemo.CSV, 2022-12-10 LRE MEAS_przemo_parsed.CSV]
